chinart123/STM32_Quadcopter/docs/project-architecture.txt

# CẤU TRÚC HỆ THỐNG THƯ MỤC: DUAL-PLATFORM QUADCOPTER

====================================================================
📦 1. STM32_Quadcopter_Legacy_Project (Cấu trúc cũ dự tính - Trước khi Refactor)
====================================================================
 ┣ 📂 1_Docs_and_Reports               <-- (Tài liệu báo cáo đồ án)
 ┃ ┗ 📜 1_M1Report_Template_updated2024.docx
 ┣ 📂 assets                           <-- (Sơ đồ mạch và hình ảnh minh họa lỗi)
 ┃ ┣ 🖼️ Fail-Diagram.png
 ┃ ┣ 🖼️ PASS-DIAGRAM.png
 ┃ ┗ 🖼️ cách-đấu-dây-fail.png
 ┣ 📂 Logs_and_Debug                   <-- (Nhật ký phân tích lỗi động cơ & MOSFET)
 ┃ ┣ 📜 Stage_10-Release-Test_1_motor_Bug_note.md
 ┃ ┣ 📜 Stage10_HW_Measurement_Test_Log.md
 ┃ ┣ 📜 Stage_10.5-Motor_Hardware_Master_Document.md
 ┃ ┗ 📜 Stage-11-Refactor-Circuits.md
 ┣ 📂 Old Core_Files                   <-- (Thư viện I2C cũ xử lý Blocking)
 ┃ ┣ 📜 i2c_mpu_debug.h
 ┃ ┗ 📜 i2c_mpu_debug.c                <-- (Chặn CPU bằng timeout t--)
 ┣ 📂 docs                             <-- (Tài liệu kỹ thuật STM32)
 ┣ 📂 include                          <-- (Header files của HAL)
 ┃ ┣ 📜 drn_main_board_choose.h
 ┃ ┣ 📜 drn_time.h
 ┃ ┣ 📜 drn_button.h
 ┃ ┣ 📜 drn_motor_pwm.h
 ┃ ┗ 📜 drn_timer_pwm.h
 ┣ 📂 src                              <-- (Source files của HAL)
 ┃ ┣ 📜 drn_main_board_choose.c
 ┃ ┣ 📜 drn_time.c                     <-- (Đếm SysTick 1ms)
 ┃ ┣ 📜 drn_button.c
 ┃ ┣ 📜 drn_motor_pwm.c
 ┃ ┗ 📜 drn_timer_pwm.c                <-- (Cấu hình TIM3 500Hz/4kHz)
 ┣ 📜 .gitignore
 ┗ 📜 README.md

====================================================================
📦 2. STM32_Quadcopter_BareMetal (Cấu trúc hiện tại - Chuẩn Zero-Config)
====================================================================
 ┣ 📂 1_Docs_and_Reports               <-- (Tài liệu báo cáo đồ án)
 ┃ ┗ 📜 1_M1Report_Template_updated2024.docx
 ┣ 📂 assets                           <-- (Sơ đồ mạch và hình ảnh minh họa lỗi)
 ┃ ┣ 🖼️ Fail-Diagram.png
 ┃ ┣ 🖼️ PASS-DIAGRAM.png
 ┃ ┗ 🖼️ cách-đấu-dây-fail.png
 ┣ 📂 Logs_and_Debug                   <-- (Nhật ký phân tích lỗi động cơ & MOSFET)
 ┃ ┣ 📜 Stage_10-Release-Test_1_motor_Bug_note.md
 ┃ ┣ 📜 Stage10_HW_Measurement_Test_Log.md
 ┃ ┣ 📜 Stage_10.5-Motor_Hardware_Master_Document.md
 ┃ ┗ 📜 Stage-11-Refactor-Circuits.md
 ┣ 📂 docs                             <-- (Tài liệu kỹ thuật STM32)
 ┃
 ┣ 📂 Old_Core_Files                   <-- (Nơi phong ấn các file Legacy/Blocking thế hệ 1)
 ┃ ┣ 📜 button.c / .h                  <-- (Thế hệ 1 - Đã được thay bởi drn_button)
 ┃ ┣ 📜 main_board_choose.c / .h       <-- (Thế hệ 1 - Đã được thay bởi drn_main_board_choose)
 ┃ ┗ 📜 i2c_mpu_debug.c / .h           <-- (I2C Polling cũ, gây nghẽn CPU)
 ┃
 ┣ 📂 include                          <-- (Header files ĐANG ACTIVE)
 ┃ ┣ 📜 hal_timer_pwm.h                <-- (BẮT BUỘC GIỮ LẠI: Định nghĩa TIM3 PWM)
 ┃ ┣ 📜 drn_button.h
 ┃ ┣ 📜 xx_mpu_data_fusion.h           
 ┃ ┗ ... (các file .h khác)
 ┃
 ┣ 📂 src                              <-- (Source files ĐANG ACTIVE)
 ┃ ┣ 📜 hal_timer_pwm.c                <-- (BẮT BUỘC GIỮ LẠI: Được pid_control.c gọi)
 ┃ ┣ 📜 main.c
 ┃ ┣ 📜 pid_control.c
 ┃ ┣ 📜 drn_button.c
 ┃ ┣ 📜 xx_mpu_data_fusion.c           <-- (Tạm thời giữ ở đây để build qua, chờ Giai đoạn 2)
 ┃ ┗ ... (các file .c khác)
 ┃
 ┣ 📜 stm32f10x.h                      <-- (File CMSIS do Keil RTE quản lý, KHÔNG DI CHUYỂN)
 ┣ 📜 .gitignore                       <-- (Chứa cấu hình loại bỏ thư mục rác Objects/ Listings/)
 ┣ 📜 STM32_Quadcopter.uvprojx         <-- (Đã được Script tự động update đường dẫn)
 ┗ 📜 README.md

📦 ESP32_S3_Quadcopter_RTOS_Project
 ┣ 📂 1_Docs_and_Reports               <-- (Tài liệu báo cáo đồ án)
 ┃ ┗ 📜 1_M1Report_Template_updated2024.docx
 ┣ 📂 assets                           <-- (Công cụ tính toán & Sơ đồ kiến trúc mới)
 ┃ ┣ 🌐 drone_budget.html
 ┃ ┣ 🌐 drone_budget-v2.html
 ┃ ┗ 🖼️ ESP32-S3-DualCore-Architecture.png
 ┣ 📂 Logs_and_Debug                   <-- (Nhật ký phát triển RTOS)
 ┃ ┣ 📜 Design_Analysis_Log.md
 ┃ ┗ 📜 PWM_16kHz_Thermal_Report.md
 ┣ 📂 Old Core_Files                   <-- (Lưu trữ code cũ để tham khảo refactor)
 ┃ ┗ 📜 old_esp32_mpu_i2c_v1.c
 ┣ 📂 docs                             <-- (Tài liệu lý thuyết RTOS)
 ┃ ┣ 📜 Lý thuyết Ngắt (Interrupt) trên ESP32-S3 & FreeRTOS.md
 ┃ ┣ 📜 Thông số Lấy mẫu & Cấu hình MPU6500.md
 ┃ ┗ 📜 Tổng hợp_Kiến_trúc_Lõi_Kép.md
 ┣ 📂 include                          <-- (Header files dùng cho ESP-IDF)
 ┃ ┣ 📜 drn_main_board_choose.h
 ┃ ┣ 📜 drn_time.h
 ┃ ┣ 📜 drn_button.h
 ┃ ┣ 📜 drn_raw_mpu6050.h
 ┃ ┣ 📜 drn_mpu6050.h
 ┃ ┣ 📜 drn_motor_pwm.h
 ┃ ┗ 📜 drn_timer_pwm.h
 ┣ 📂 src                              <-- (Source files & ESP-IDF Components)
 ┃ ┣ 📜 drn_main_board_choose.cpp
 ┃ ┣ 📜 drn_time.cpp                     <-- (FreeRTOS Tick/esp_timer)
 ┃ ┣ 📜 drn_button.cpp
 ┃ ┣ 📜 drn_raw_mpu6050.cpp
 ┃ ┣ 📜 drn_mpu6050.cpp
 ┃ ┣ 📜 drn_motor_pwm.cpp
 ┃ ┗ 📜 drn_timer_pwm.cpp                <-- (Cấu hình LEDC 16kHz)
 ┣ 📜 CMakeLists.txt                   <-- (Project-level: Khởi tạo dự án ESP-IDF)
 ┣ 📜 sdkconfig                        <-- (Cấu hình CONFIG_ cho RTOS, Clock 240MHz...)
 ┣ 📂 main                             <-- (Thư mục ứng dụng chính)
   ┣ 📜 CMakeLists.txt                 <-- (Component-level: Đăng ký source code)
   ┗ 📜 main.cpp                       <-- (Entry point: Khởi tạo Task điều khiển bay)
 ┣ 📂 Arduino_IDE/
 ┃ ┗ 📂 ESP32_Quadcopter/                   # Tên thư mục = tên file .ino
 ┃    ┣ 📜 ESP32_Quadcopter.ino             # Entry point (setup/loop)
 ┃    ┣ 📂 src/                             # Symbolic link hoặc copy tới ../src/
 ┃    ┃  ┣ 🔗 drn_main_board_choose.cpp -> ../../../src/drn_main_board_choose.cpp
 ┃    ┃  ┣ 🔗 drn_time.cpp                 -> ../../../src/drn_time.cpp
 ┃    ┃  ┣ 🔗 drn_button.cpp               -> ../../../src/drn_button.cpp
 ┃    ┃  ┣ 🔗 drn_raw_mpu6050.cpp               -> ../../../src/drn_raw_mpu6050.cpp
 ┃    ┃  ┣ 🔗 drn_mpu6050.cpp               -> ../../../src/drn_mpu6050.cpp
 ┃    ┃  ┣ 🔗 drn_timer_pwm.cpp            -> ../../../src/drn_timer_pwm.cpp
 ┃    ┃  ┗ 🔗 drn_motor_pwm.cpp            -> ../../../src/drn_motor_pwm.cpp
 ┃    ┣ 📂 include/                         # Symbolic link tới ../include/
 ┃    ┃  ┣ 🔗 drn_main_board_choose.h      -> ../../../include/drn_main_board_choose.h
 ┃    ┃  ┣ 🔗 drn_time.h                   -> ../../../include/drn_time.h
 ┃    ┃  ┣ 🔗 drn_button.h                 -> ../../../include/drn_button.h
 ┃    ┃  ┣ 🔗 drn_raw_mpu6050.h                 -> ../../../include/drn_raw_mpu6050.h
 ┃    ┃  ┣ 🔗 drn_mpu6050.h                 -> ../../../include/drn_mpu6050.h
 ┃    ┃  ┣ 🔗 drn_timer_pwm.h              -> ../../../include/drn_timer_pwm.h
 ┃    ┃  ┗ 🔗 drn_motor_pwm.h              -> ../../../include/drn_motor_pwm.h
 ┃    ┗ 📂 libraries/                       # (Tuỳ chọn) Thư viện bổ sung cho Arduino
 ┣ .gitignore
 ┗ README.md
