chinart123/STM32_Quadcopter/assets/nmos.pdf

EE 230 | MOSFETs – 1

## Metal oxide semiconductor field effect transistors (MOSFETs)

A newer form of transistor which has pretty much replaced BJT technology for all digital applications and much of analog.

Basically, an FET is a resistor whose resistance can be controlled through a third terminal. So the transistor mechanism is much different than that of the BJT. A BJT used both electrons and holes injected across the junctions (hence bipolar). An FET uses either electrons or holes (hence unipolar) flowing by drift current between two contacts (source and drain). The amount of flow is controlled by a voltage applied at the gate.

electron-current device: n-channel MOSFET (NMOS) hole-current device: p-channel MOSFET (PMOS)

Using NMOS and PMOS together (known as CMOS) offers some significant advantages in circuit design.

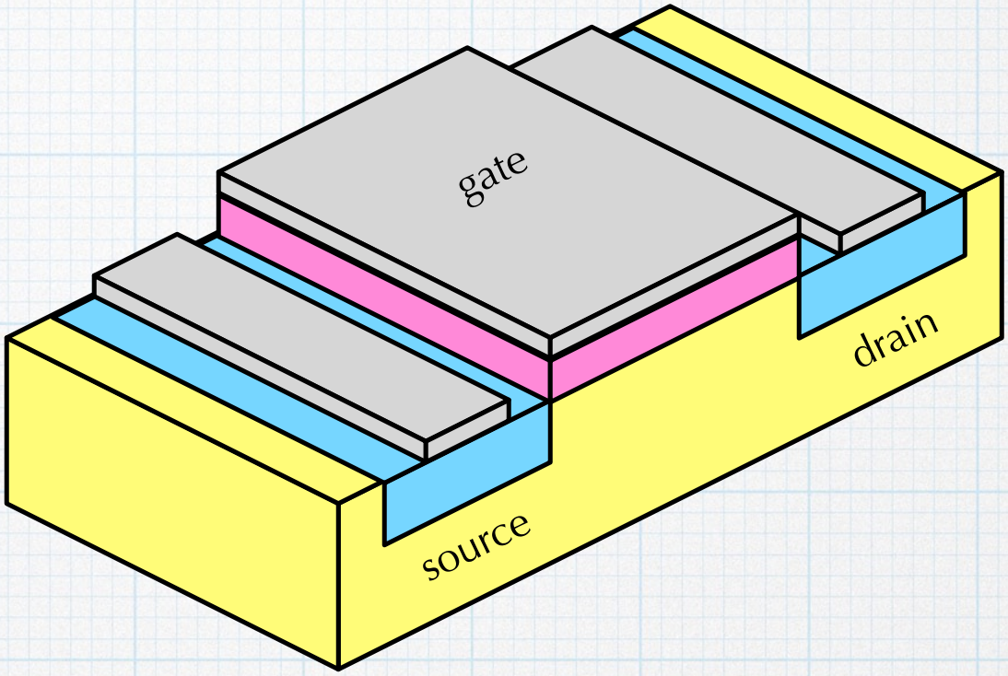
[picture p4: figure]
source; drain; oxide; gate

PMOS has n- and p-type regions reversed. (Duh!)

Start with a p-type substrate.

Form two n-type regions
(source & drain)

Form a thin layer of silicon dioxide on the p-type silicon between source and drain

Put metal contacts on the
source, drain, and oxide (gate) for electrical connection

## Basic NMOS structure

(n-channel device)

## Basic NMOS structure

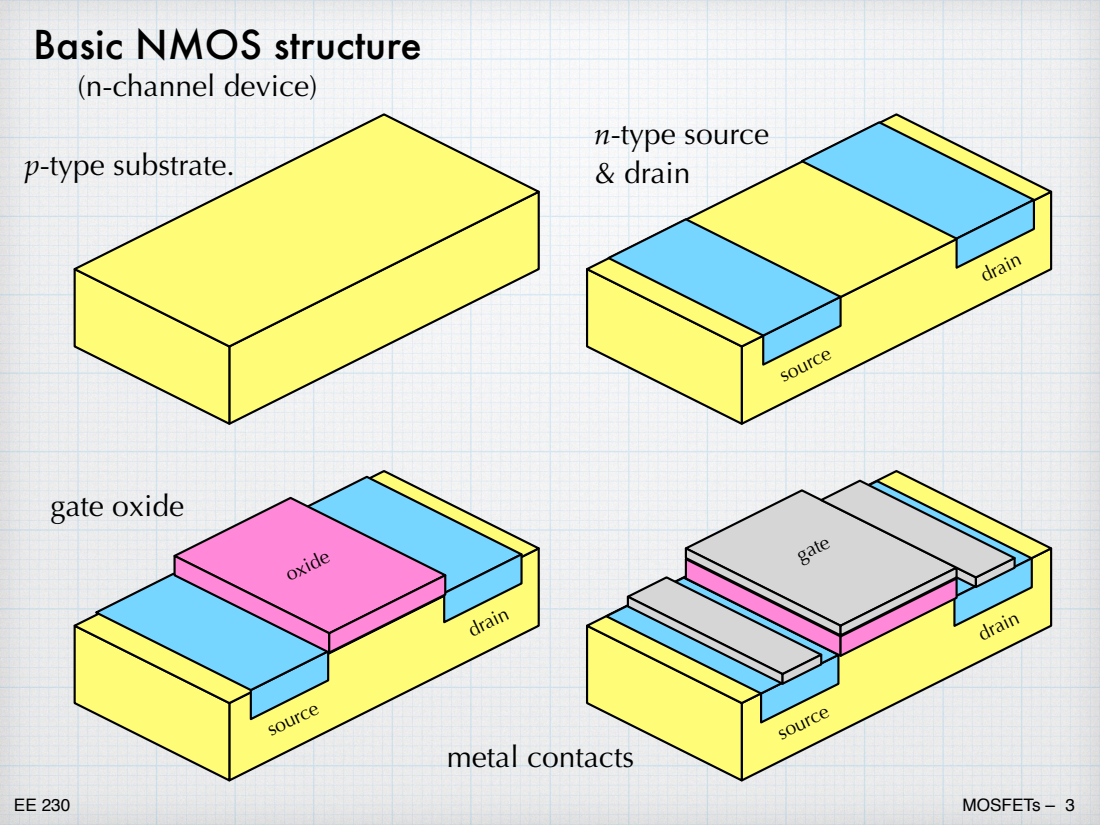
[picture p5: page 3]
source; drain; oxide; gate; (n-channel device); p-type substrate.; n-type source & drain; gate oxide; metal contacts

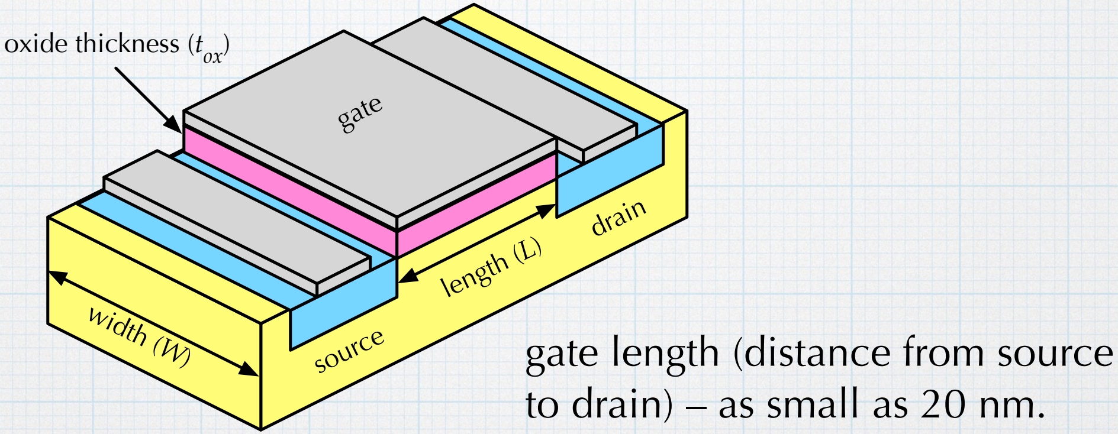
[picture p6: figure]
source; drain; oxide; gate; gate length (distance from source to drain) – as small as 20 nm.; length (L); width (W); oxide thickness (t

EE 230 | MOSFETs –

4

## Critical dimensions

width: typical L to 10 L
(W/L ratio is important)

oxide thickness: typical 1 - 10 nm.

Will current flow?
Apply a voltage between drain and source (VDS).

If VDS > 0, the diode at the drain end will be reverse-biased, preventing current flow.

Reversing the polarity doesn’t help, because then the other junction will be reverse biased.

source | drain

gate

p

n | n

–

+

VDS

## The MOS capacitor

The secret to MOSFET operation lies in the MOS capacitor (the central part of the FET).

The structure is essentially a little parallel-plate capacitor formed by the gate metal and the semiconductor with the oxide as the dielectric.

Define oxide
capacitance

&JDWH =

R[$

WR[

&R[ =

R[

WR[

gate body

substrate (body)

units: F/m² (or F/µm²)

εox = 3.9εo = 3.9(8.85x10⁻¹² F/m) for tox = 10 nm (10⁻⁸ m)
Cox = 0.00345 F/m²
= 3.45x10⁻¹⁵ F/µm²

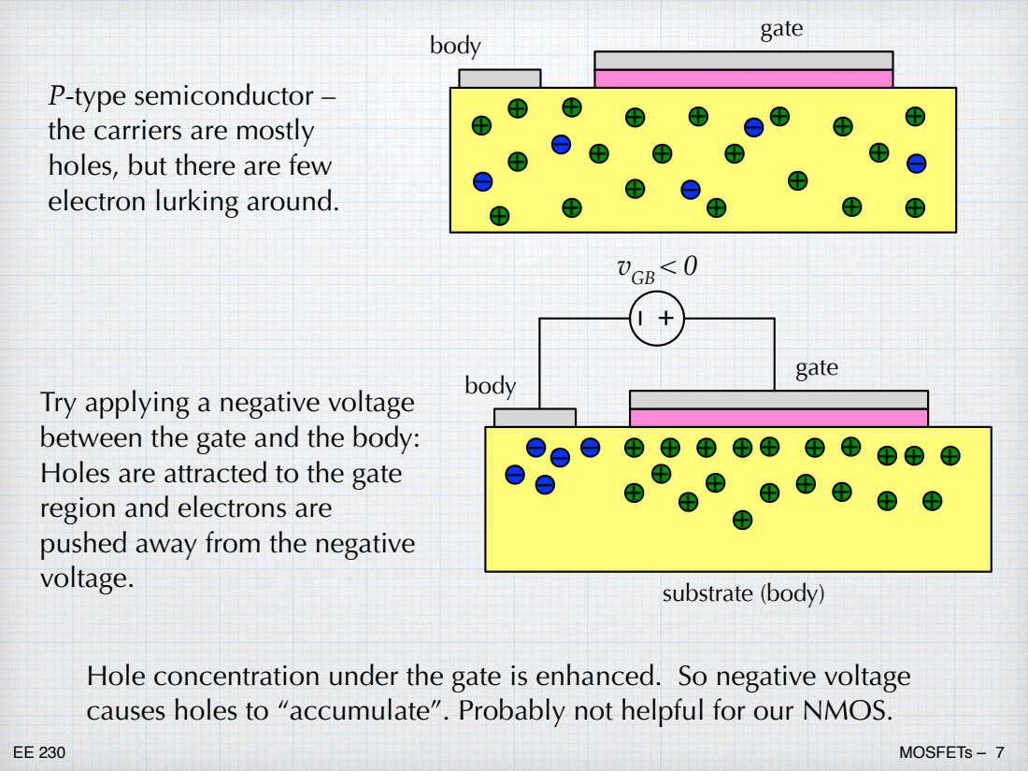
[picture p7: page 7]
gate body; gate; vGB < 0; body; substrate (body)

P-type semiconductor –
the carriers are mostly
holes, but there are few
electron lurking around.

Try applying a negative voltage
between the gate and the body:
Holes are attracted to the gate
region and electrons are
pushed away from the negative
voltage.

Hole concentration under the gate is enhanced. So negative voltage
causes holes to “accumulate”. Probably not helpful for our NMOS.

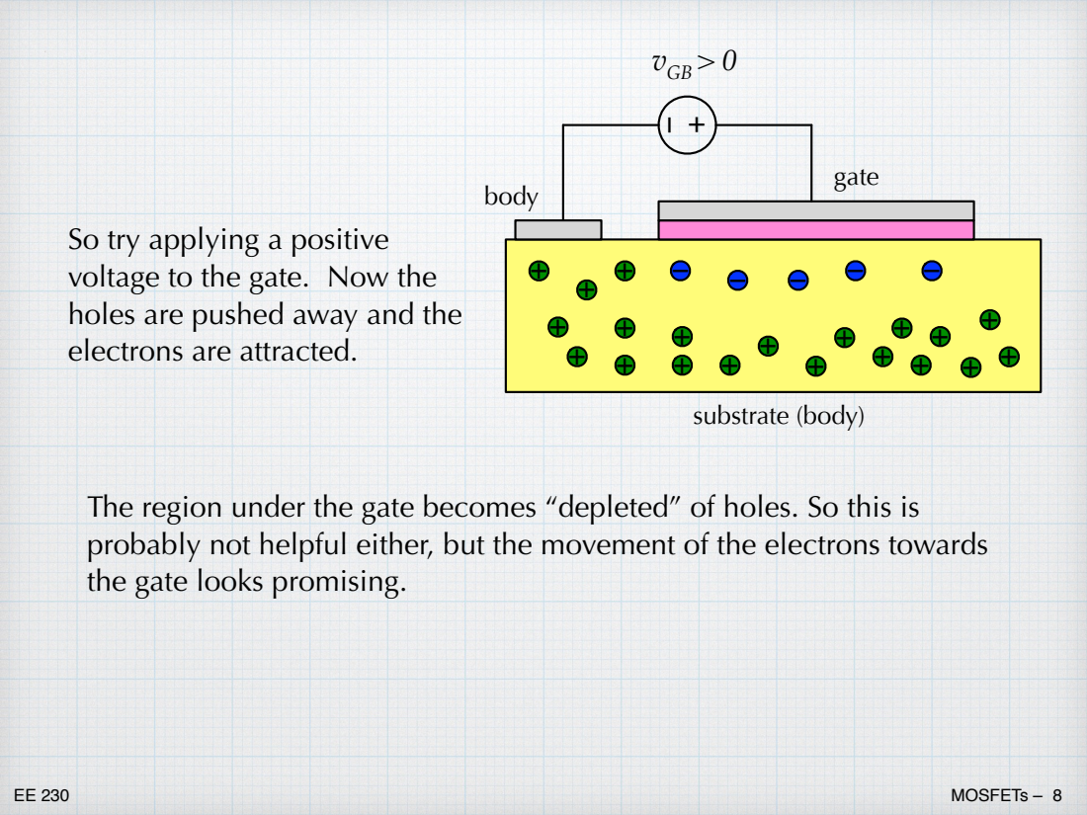
[picture p8: page 8]
gate; vGB > 0; body; substrate (body)

So try applying a positive
voltage to the gate. Now the
holes are pushed away and the
electrons are attracted.

The region under the gate becomes “depleted” of holes. So this is
probably not helpful either, but the movement of the electrons towards
the gate looks promising.

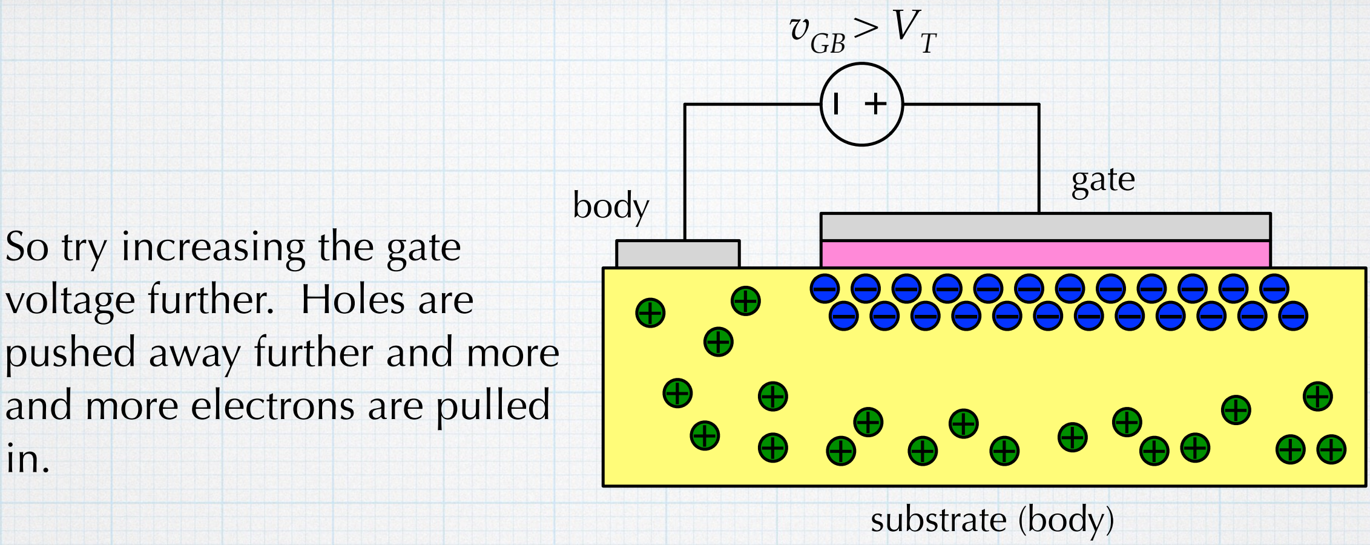
[picture p9: figure]
So try increasing the gate voltage further. Holes are pushed away further and more and more electrons are pulled in.; gate; vGB > VT; body; substrate (body)

At a sufficiently high voltage, enough electrons will gather together to make the region under the gate “invert” and behave like it was n-type!

The gate voltage required create the electron “inversion layer” is called the threshold voltage, VT

. If the voltage is increase beyond VT

, even
more electrons are gathered together under the gate.

+ – – – – – – – – – – – – – – – – – – – – – – – –

## The inversion layer

How many electrons are in the inversion layer? The definition of the threshold voltage says that when vGB = VT, the electron concentration in the inversion layer is equal to the
hole concentration in the substrate:
n(inversion) = p(substrate).

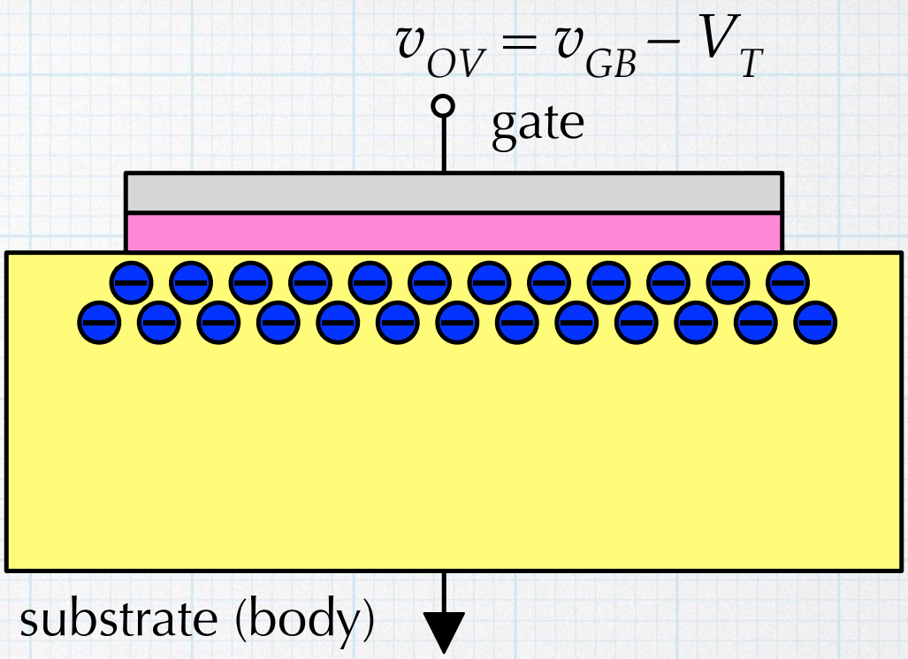
[picture p10: figure]
gate; substrate (body); vOV = vGB – VT

This gives just enough electrons so that the region under the gate begins to act like it is n-type. A detailed physical description is beyond our capabilities now. (See EE 332 and beyond.) But we can get a good approximation by using the fact that the MOS structure is basically a capacitor. Once the gate voltage is bigger than the threshold, electrons pile up under gate just like charge on a plate of a capacitor.

4LQY
$

= &R[ (Y%* 97)= TQV

where ns is the sheet concentration of electrons in the inversion layer. (electrons per unit area).

– – – – – – – – – – – – – – – – – – – – – – – –

Qinv = Cgate (vGB VT)

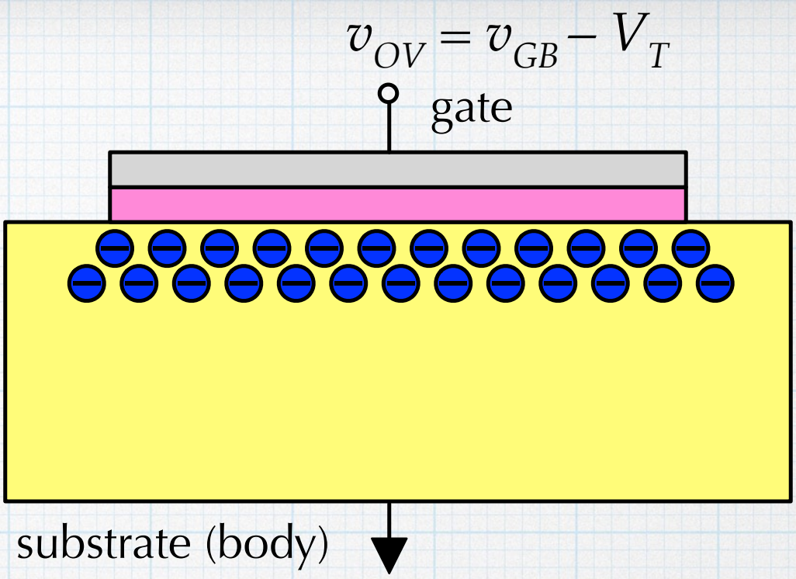
[picture p11: figure]
substrate (body); vOV = vGB – VT

The threshold voltage | gate
| – – – – – – – – – – – – – – – – – – – – – – – –

The threshold voltage for a MOSFET depends primarily on two things. The doping level of the substrate and the
thickness of the insulating gate oxide
layer.

The definition of threshold is that the electron concentration under the gate is equal to the hole concentration in the rest of the substrate. If the hole concentration in the substrate is higher (due to higher doping) more voltage is required to induce the higher number of electrons needed for inversion. Increased doping means higher threshold.
The electric field in MOS capacitor in the gate that controls what is happening in the inversion layer. Since E ∝ vGB/tox , making the oxide thicker requires more voltage in order to create the same electric field. So a thicker oxide also leads to higher a threshold voltage.
Integrated circuit fabrication engineers work very hard to control the threshold voltages of the MOSFETs. Not easy when there are millions (or billions) of transistors in a chip!

vGB < 0 | hole accumulation
0 < vGB < VT | carrier depletion
vGB > VT | inversion – electron layer forms, qns = Cox(vGB – VT)

So through the application of the gate voltage, we control carriers under the gate.

## Summary of MOS capacitor operation

Now we see a mechanism by which we might get current to flow between drain and source.
Apply a gate voltage to create an electron inversion layer. Then electrons from the source can flow to the drain using the inversion

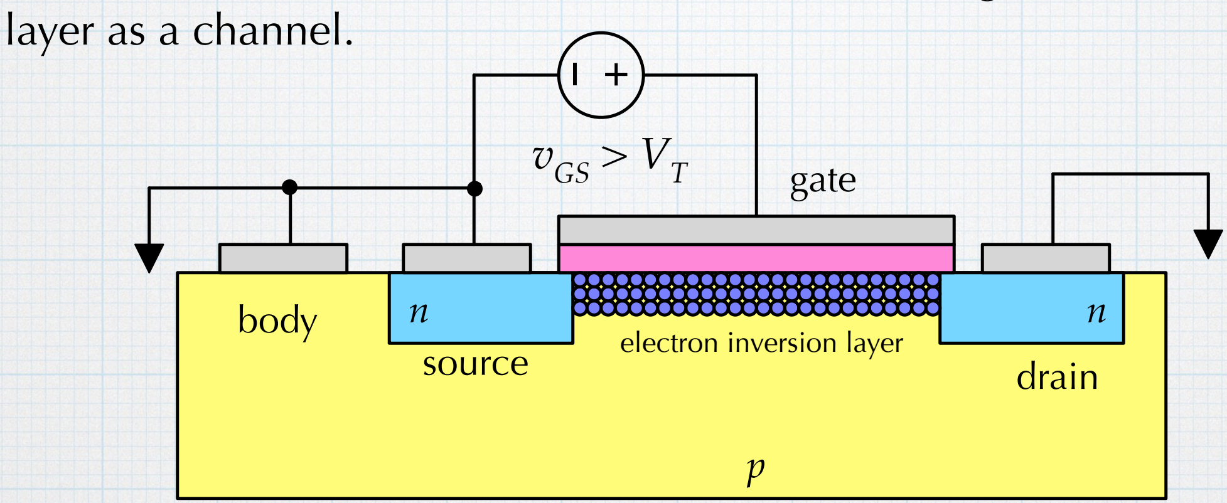
[picture p12: figure]
layer as a channel.; drain source; gate; vGS > VT; electron inversion layer; body

For now, we connect the source to the body (call this ground) and apply the controlling voltage between the gate and the source. This is OK for the time being, but we will have to revisit the issue of the body connection later. With the drain also at ground, the inversion layer (channel) is uniform between source and drain.

## Drain resistance

With the inversion layer in place, we can apply a positive voltage between the drain and source. This creates an electric field along the channel that will push electrons from the source through the inversion layer to the drain. The moving electrons represent a current in the opposite direction — from drain to source.

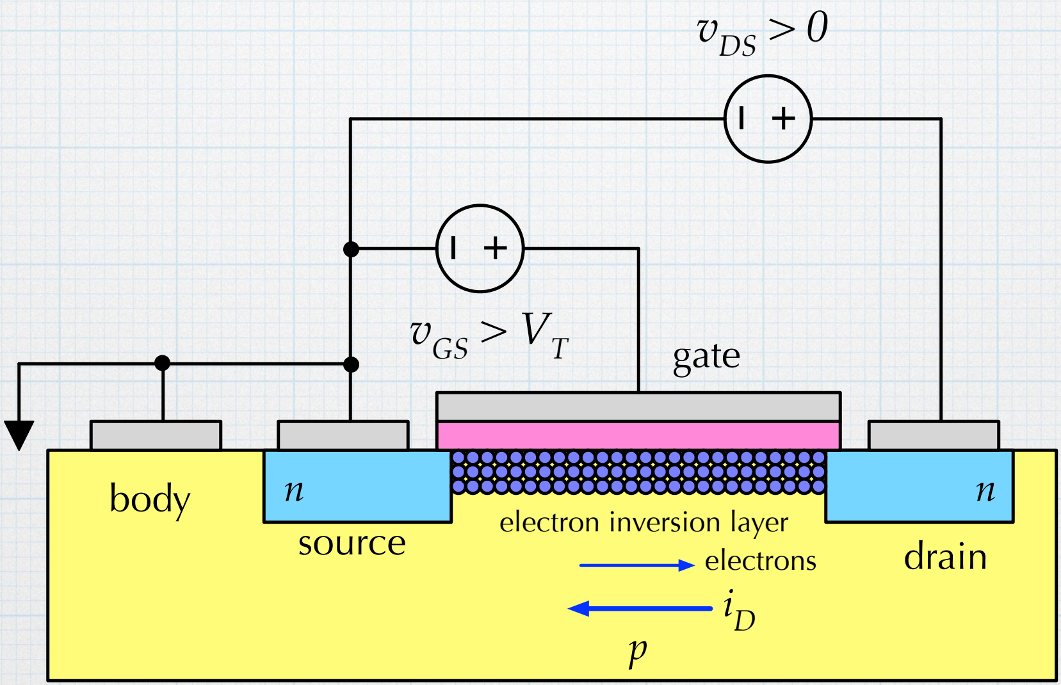
[picture p13: figure]
drain source; gate; vGS > VT; electron inversion layer; vDS > 0; electrons; body

At first inspection, the current is

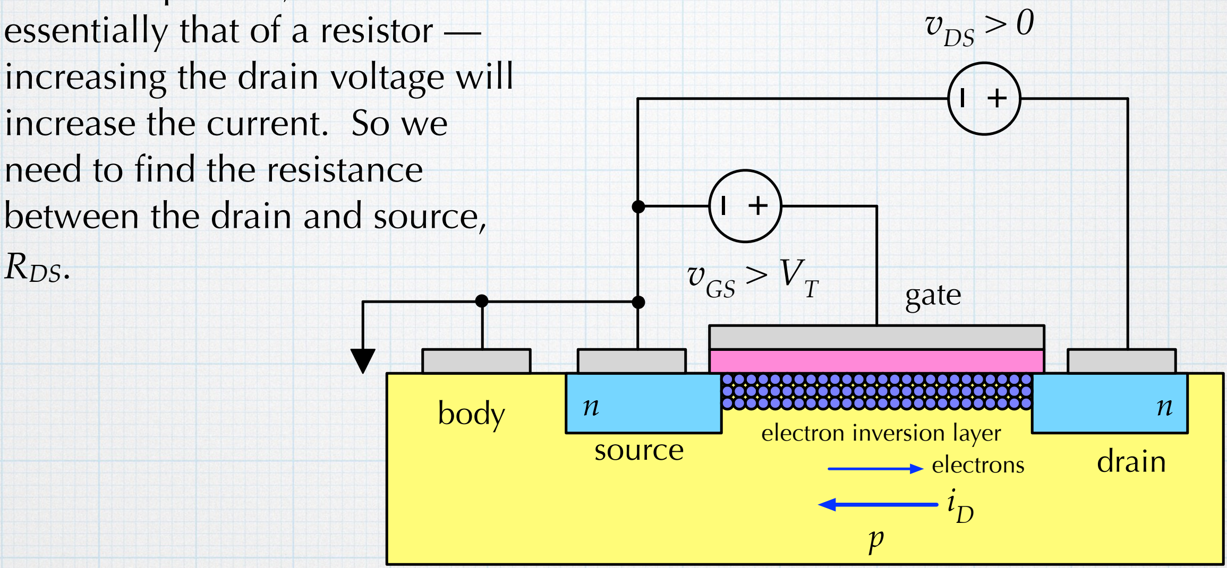
[picture p14: figure]
essentially that of a resistor — increasing the drain voltage will increase the current. So we need to find the resistance between the drain and source,; RDS.; drain source; gate; vGS > VT; electron inversion layer; vDS > 0; electrons; body

The total resistance is the sum the resistances of the three regions: RDS = Rsource + Rinversion + Rdrain. Usually, the source and drain are very heavily doped (lots of electrons) and so the resistances in those regions are very small. Most of the resistance is associated with the inversion layer so

that RDS ≈ Rinversion.

Using the basic definition for a resistor:

where ninv is the electron concentration (m⁻³) in the inversion layer, tinv is the “thickness” of the inversion layer, µn is the electron mobility, q is the charge on one electron and L and W are the gate length and width.

The electron concentration and inversion layer thickness are difficult to quantify because of the sheet-like nature of the inversion layer. However, the product ninv· tinv can be re-expressed more easily – it represents the “sheet concentration” (m⁻²) of electrons in the inversion layer, which we denote as ns.

We saw earlier that: TQV = &R[ (Y*6 97)

L' =

Y'6

5'6

=

TܟQQLQYWLQY :

/

Y'6

ρinv =

1

qμnninv

RDS = ρ

L
A

=

ρ

tinv L

W

Using the basic definition for a resistor:

ρinv =

1

qμnninv
where ninv is the electron concentration (m⁻³) in the inversion layer, tinv is the “thickness” of the inversion layer, µn is the electron mobility, q is the charge on one electron and L and W are the gate length and width. (See slide 4 for a reminder of the 3D geometry.) Putting the equations together:

RDS = ρinv

L
A

=

ρinv

tinv L

W

RDS =

1

qμnninvtinv L

W

L' =

Y'6

5'6

=

TܟQQLQYWLQY :

/

Y'6

The electron concentration and inversion layer thickness are difficult to quantify because of the sheet-like nature of the inversion layer. However, the product ninv· tinv can be re-expressed more easily – it represents the “sheet concentration” (m⁻²) of electrons in the inversion layer, which we denoted earlier as ns.

We saw earlier that: TQV = &R[ (Y*6 97)

iD =

qμnns

W

L

# vDS

L' =

ܟQ&R[
:
/

(Y*6 97)

Y'6 RDS =

1
μnCox

W
L
(vGS VT)

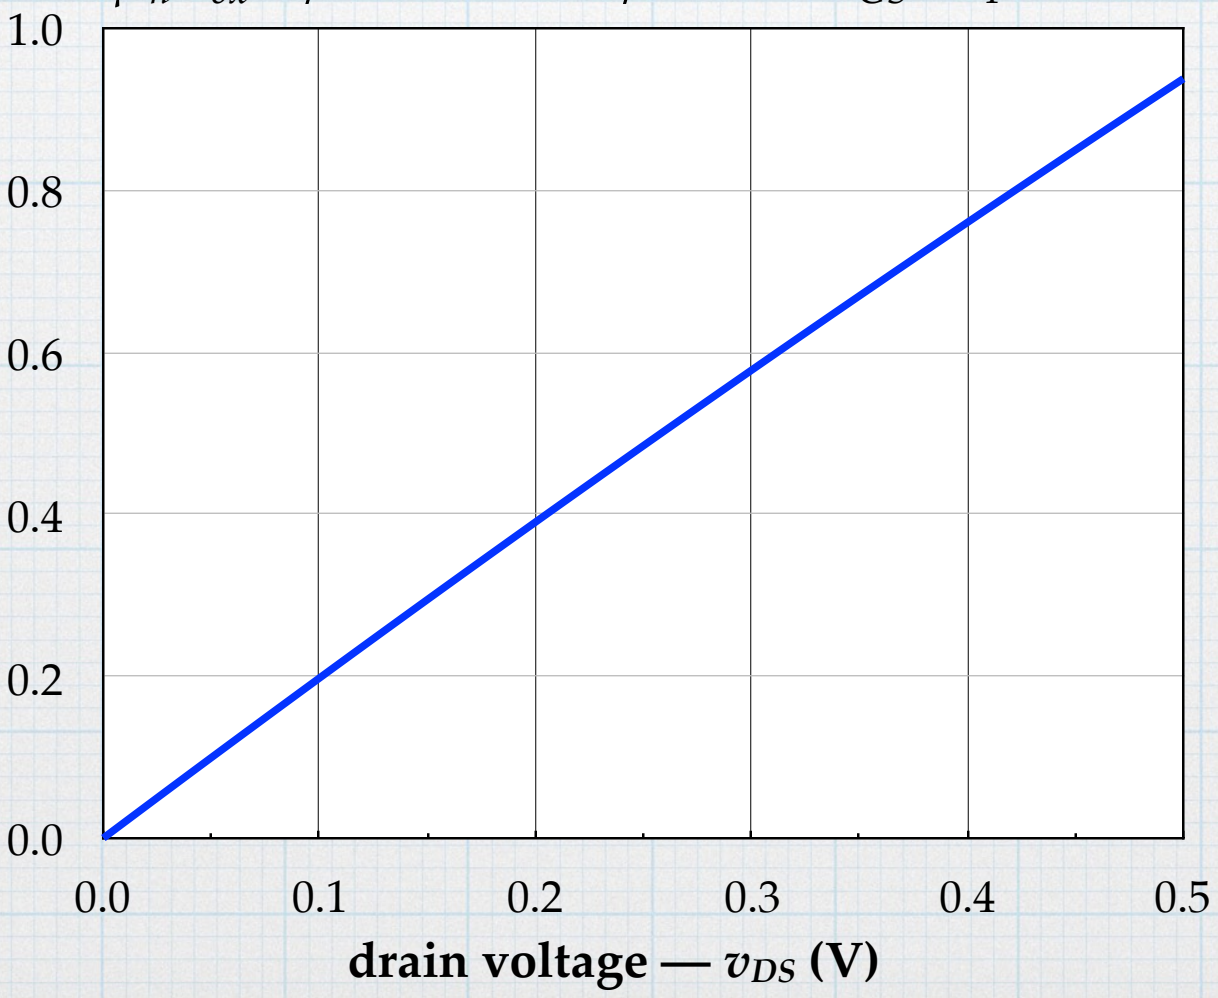
[picture p15: figure]
drain voltage — vDS (V)

µnCoxW/L = 0.5 mA/V² and vGS–VT = 4 V.

drain current —

iDS (mA)

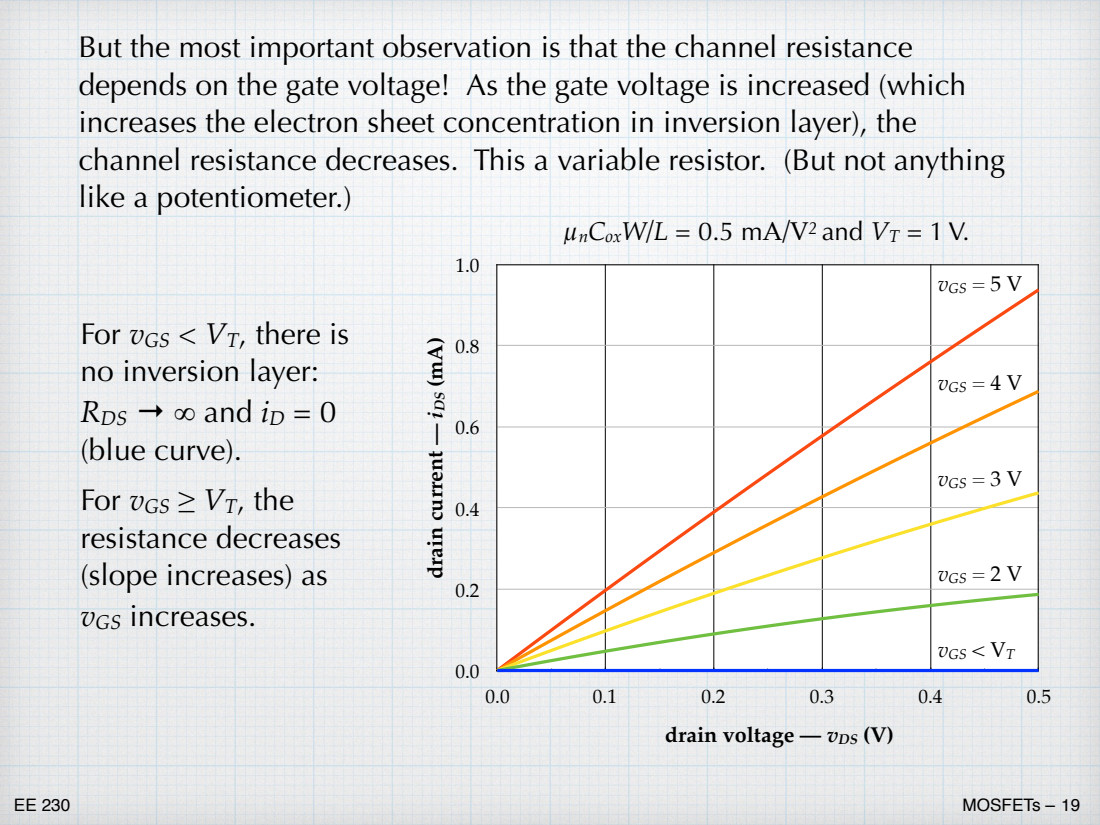
[picture p16: page 19]
drain current —; iDS (mA)

But the most important observation is that the channel resistance
depends on the gate voltage! As the gate voltage is increased (which
increases the electron sheet concentration in inversion layer), the
channel resistance decreases. This a variable resistor. (But not anything
like a potentiometer.)

µnCoxW/L = 0.5 mA/V² and VT = 1 V.

vGS = 5 V

For vGS < VT, there is
no inversion layer:
RDS → ∞ and iD = 0
(blue curve).
For vGS ≥ VT, the
resistance decreases
(slope increases) as
vGS increases.

vGS = 4 V

vGS = 3 V

vGS = 2 V

vGS < VT

drain voltage — vDS (V)

However, the picture gets more complicated as vDS increases.

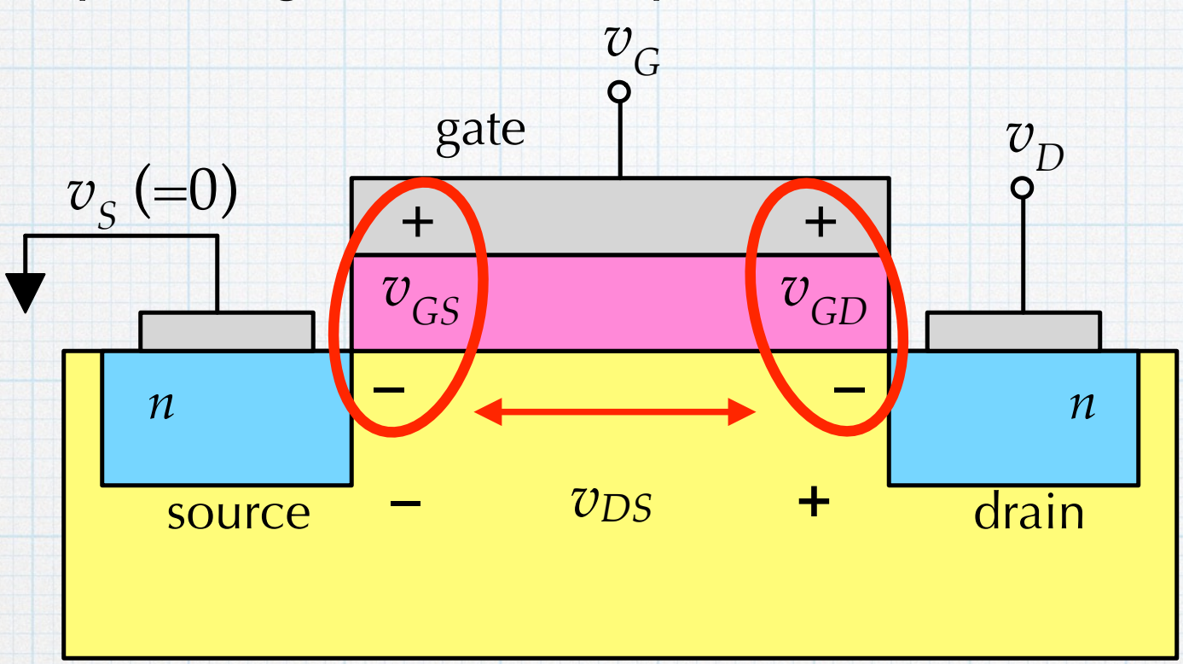
[picture p17: figure]
source; drain; gate; vGS; vGD; vDS

The electron sheet concentration depends on the local voltage of the semiconductor underneath the gate. In the MOS capacitor, the voltage of the semiconductor was the same everywhere, so the electron concentration was uniform. In the case of the MOSFET, the local voltage under the gate can vary from one end to the other. At the source end, the channel voltage is 0, (because we have tied the source to ground). At the drain end, the channel voltage is vD, because we have applied a voltage there in order to make current flow. In between, the channel voltage ranges between 0 and vD.

## Drain resistance

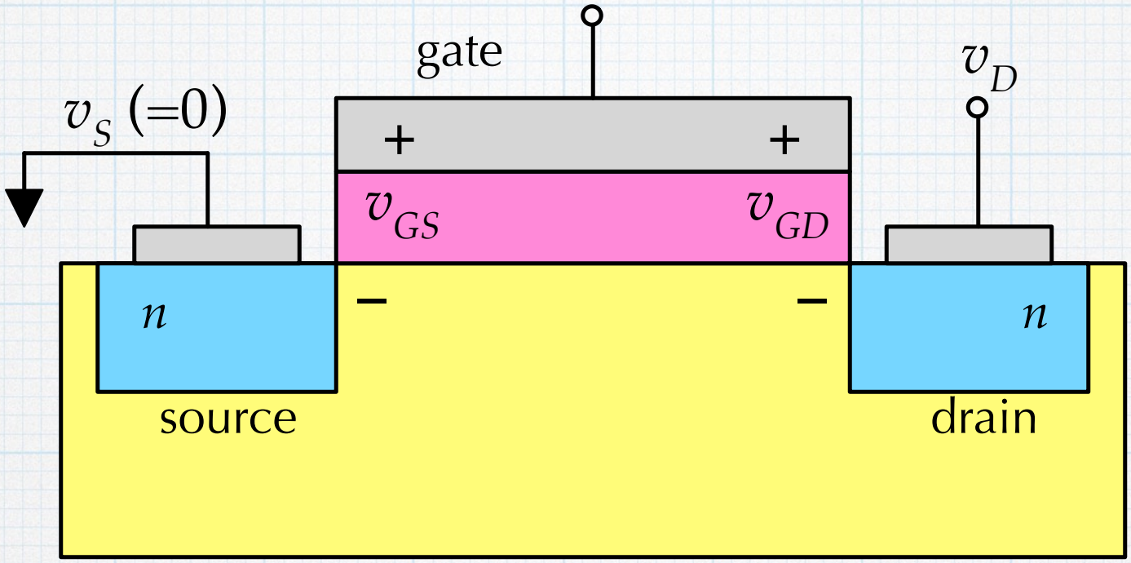
[picture p18: figure]
source; drain; gate; vGS; vGD

Since vGD = vGS – vDS, then qns = Cox(vGS – vDS – VT) at the drain end. Increasing vDS decreases vGD and so decreases the electron concentration at the drain end, increasing the incremental resistance at the drain end.

The electron sheet concentration is determined by the difference between the gate voltage and the local channel voltage. At the source end, qns = Cox(vGS – VT). At the drain end, qns = Cox(vGD – VT).

vG

The result of all this is that the inversion layer (channel) resistance is actually non-linear – the resistance changes as the drain voltage changes.

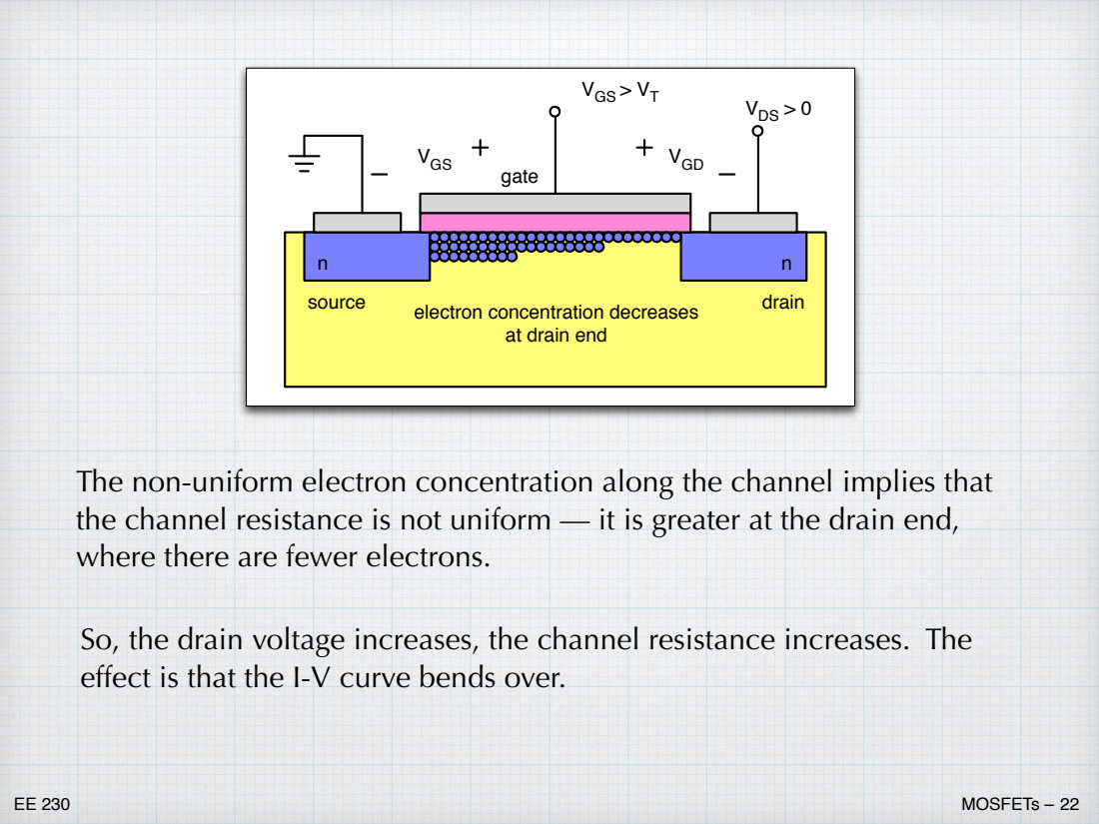
[picture p19: page 22]
source; drain; gate; VDS > 0; VGS > VT; VGS; VGD

electron concentration decreases

at drain end

The non-uniform electron concentration along the channel implies that
the channel resistance is not uniform — it is greater at the drain end,
where there are fewer electrons.

So, the drain voltage increases, the channel resistance increases. The
effect is that the I-V curve bends over.

So a more correct analysis of the current flow shows that the iD-vDS relationship is not linear, but parabolic. (See EE 332.)

Exercise: Show that this reduces to the linear equation for small values of

vDS.

L' =

ܟQ&R[

:
/
(Y*6 97) Y'6 Y

'6

µnCoxW/L = 0.5 mA/V² and vGS–VT = 4 V.

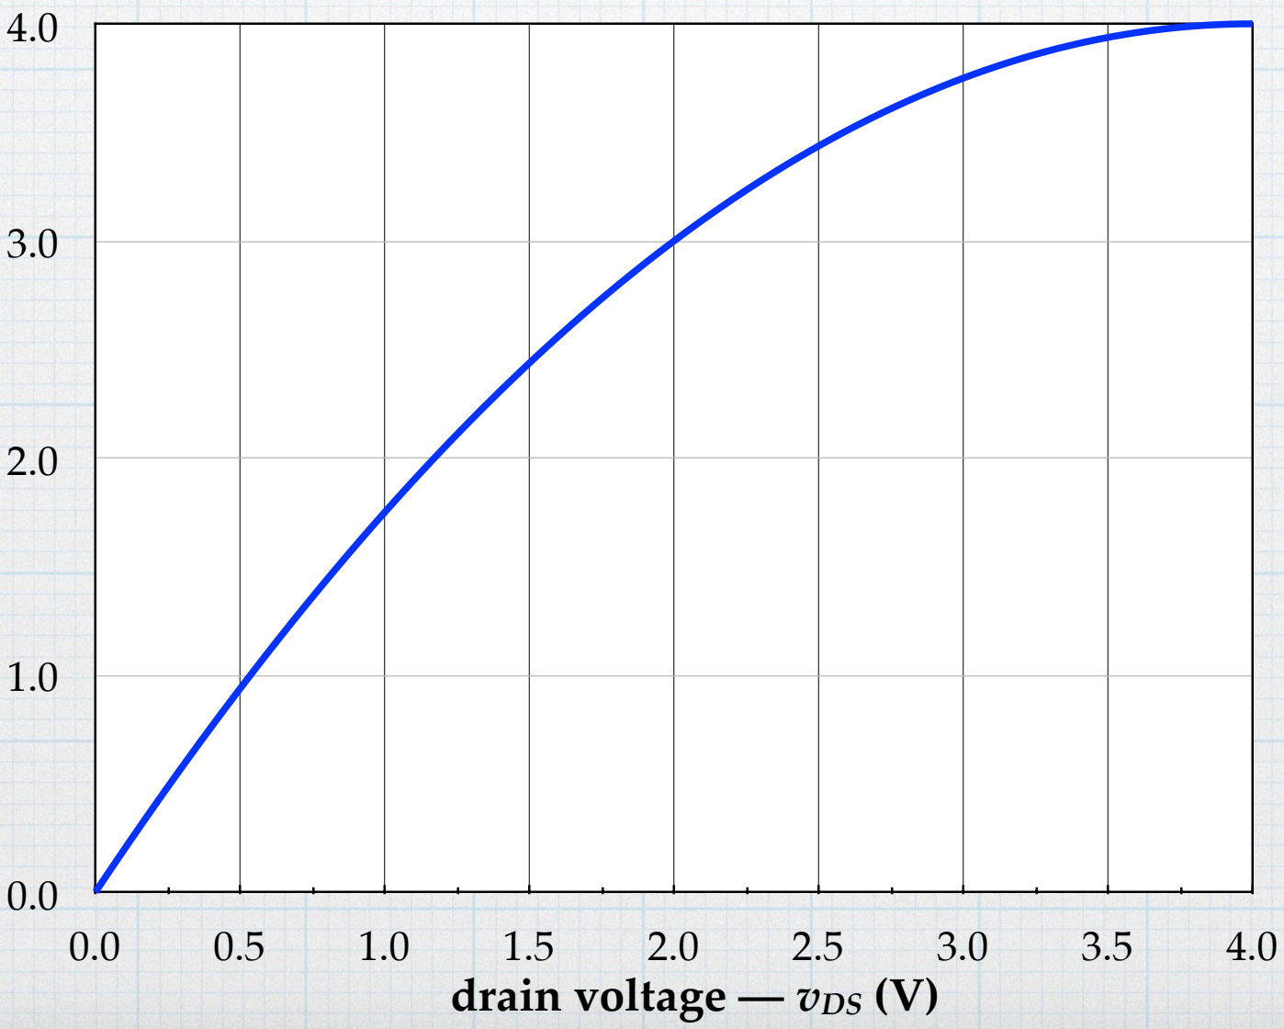
[picture p20: figure]
drain voltage — vDS (V)

drain current —

iDS (mA)

This mode of operation is known as "linear" or "ohmic". (Some old codgers also call is "triode" — but don't use that.)

L' =

ܟQ&R[

:
/
(Y*6 97) Y'6 Y

'6

. =

ܟQ&R[

:
/

Notation: To save on ink and time, define the constant in front as:

The units of this “MOS current parameter” are A/V². Or more typically mA/V². (Check it.)

Note: This use of K is not standard. Different textbooks will handle the current parameter differently.

Now take the final step: If vDS is increased sufficiently, we reach a point where vGD < VT. The electron
concentration should
disappear at the drain end!

## current saturation

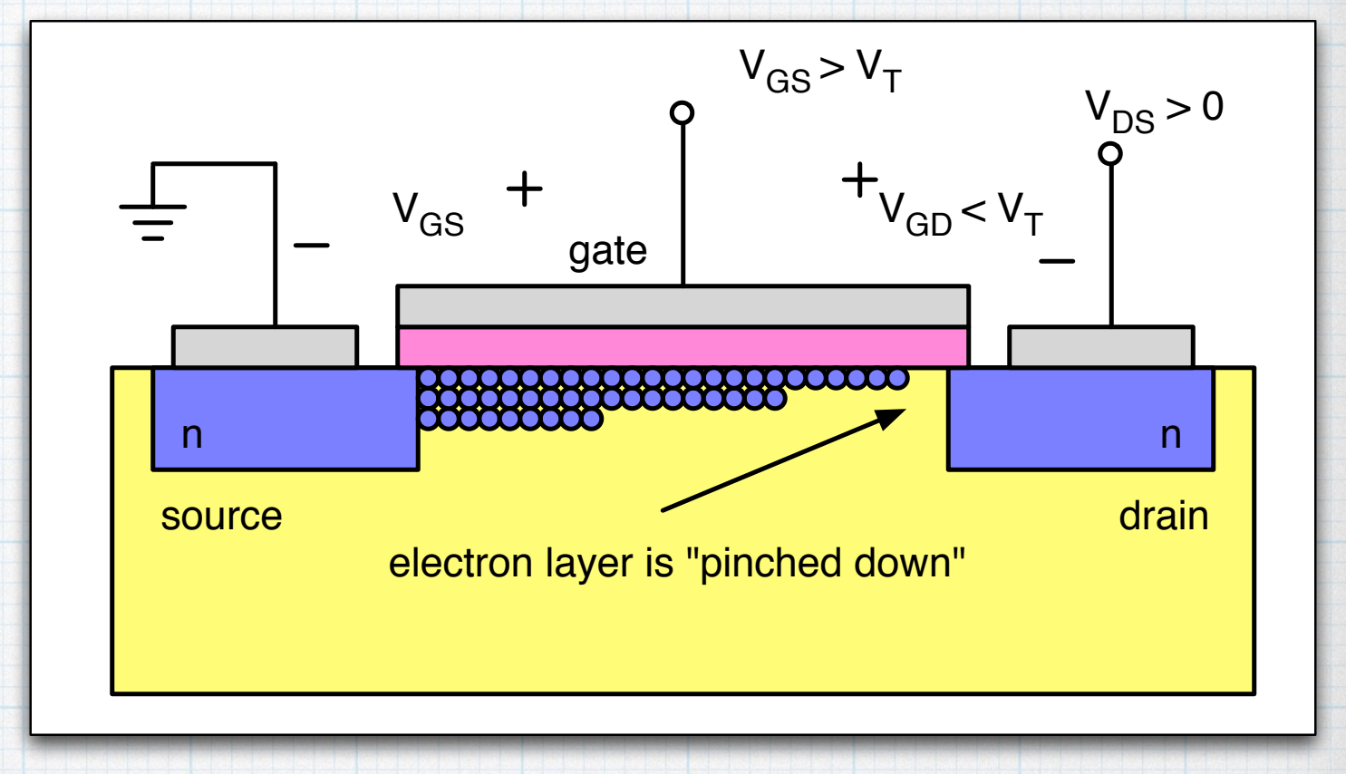
[picture p21: figure]
source; drain; gate; VDS > 0; VGS > VT; electron layer is "pinched down"; VGS; VGD < VT

The usual terminology is to say that the channel is “pinched off” at the drain end, but this is slightly misleading. If the channel were truly pinched off, then the electron concentration would go to zero there and the current would necessarily have to go to zero, also.
Instead, it might be better to say that the channel is “pinched down”. The electron concentration goes to some minimum value, but never really shuts off. In effect, the flowing current works to hold the channel open, even though the drain voltage seems high enough to truly pinch off the channel.

The mathematical analysis of what happens in a FET at pinch-off is a fairly complicated problem in electromagnetics – definitely beyond our current capabilities. (Again, see EE 332.)
However, the end result on the device behavior is easy to grasp – the current saturates at the pinch down value. For higher values of vDS, the current stays constant at a constant value.

The condition for the NMOS going reaching the “pinch-down” condition is vGD ≤ VT. This can be re-expressed in terms of vDS and vGS.

To determine the saturation current, we can insert the pinch-down condition given above into the iD-vDS equation from the ohmic region of operation. Then the saturated current is

Y'6 Y*6 97

L' (VDW)=

ܟQ&R[

:
/

[Y*6 97]

= . [Y*6 97]

(Work out these details for yourself.)

Fix vGS and vary vDS.
Plot the drain current.

## NMOS iD-vDS curves

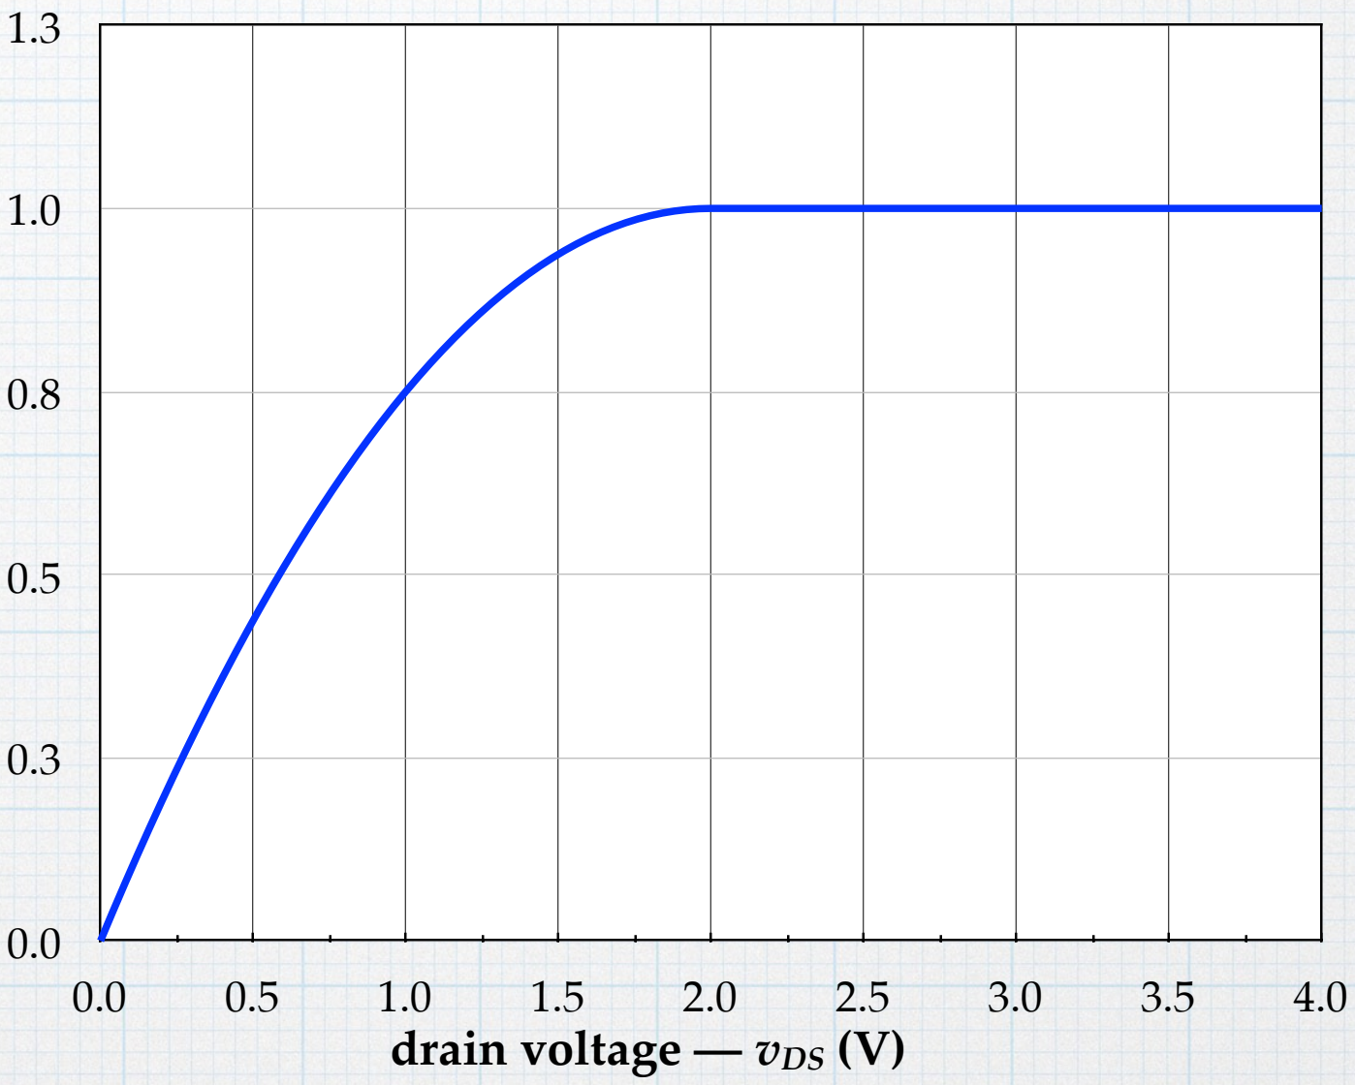
[picture p22: figure]
drain voltage — vDS (V)

For small vDS (vDS < vGS - VT), the NMOS will be in the ohmic region. At higher vDS (vDS ≥ vGS - VT), the channel pinches down and the current saturates.
If vGS < VT, there is no inversion layer and the NMOS is off (iD = 0).

drain current —

iDS (mA)

## NMOS iD-vDS curves

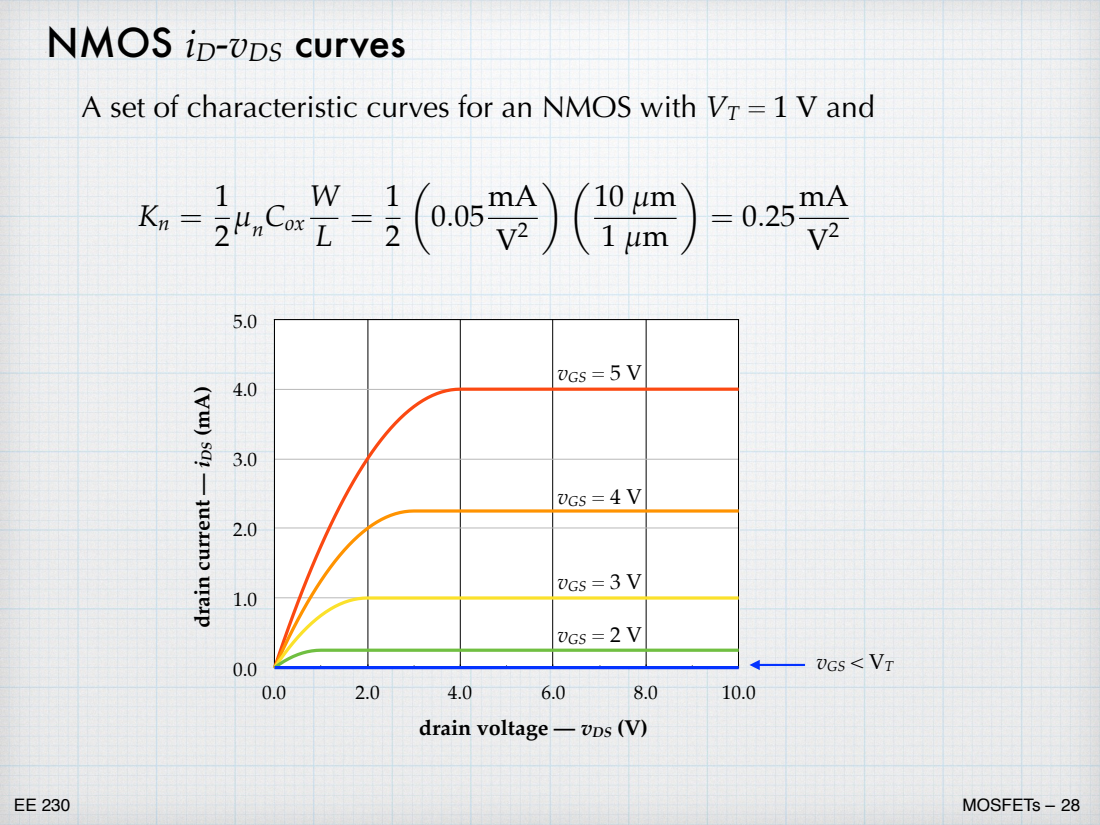
[picture p23: page 28]
MOSFETs –; μnCox; vGS = 5 V; drain current —; iDS (mA); vGS < VT

A set of characteristic curves for an NMOS with VT = 1 V and

vGS = 4 V

vGS = 3 V

vGS = 2 V

drain voltage — vDS (V)

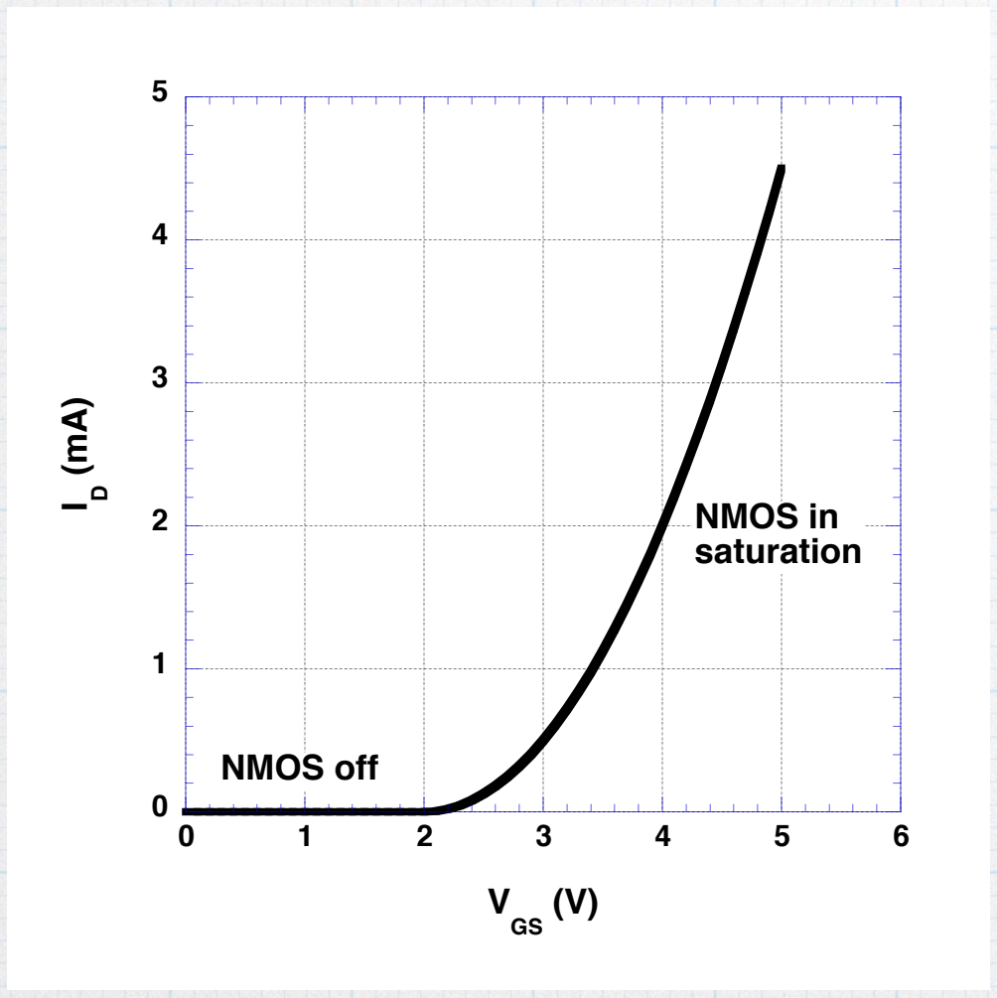
[picture p24: figure]
NMOS off; NMOS in saturation
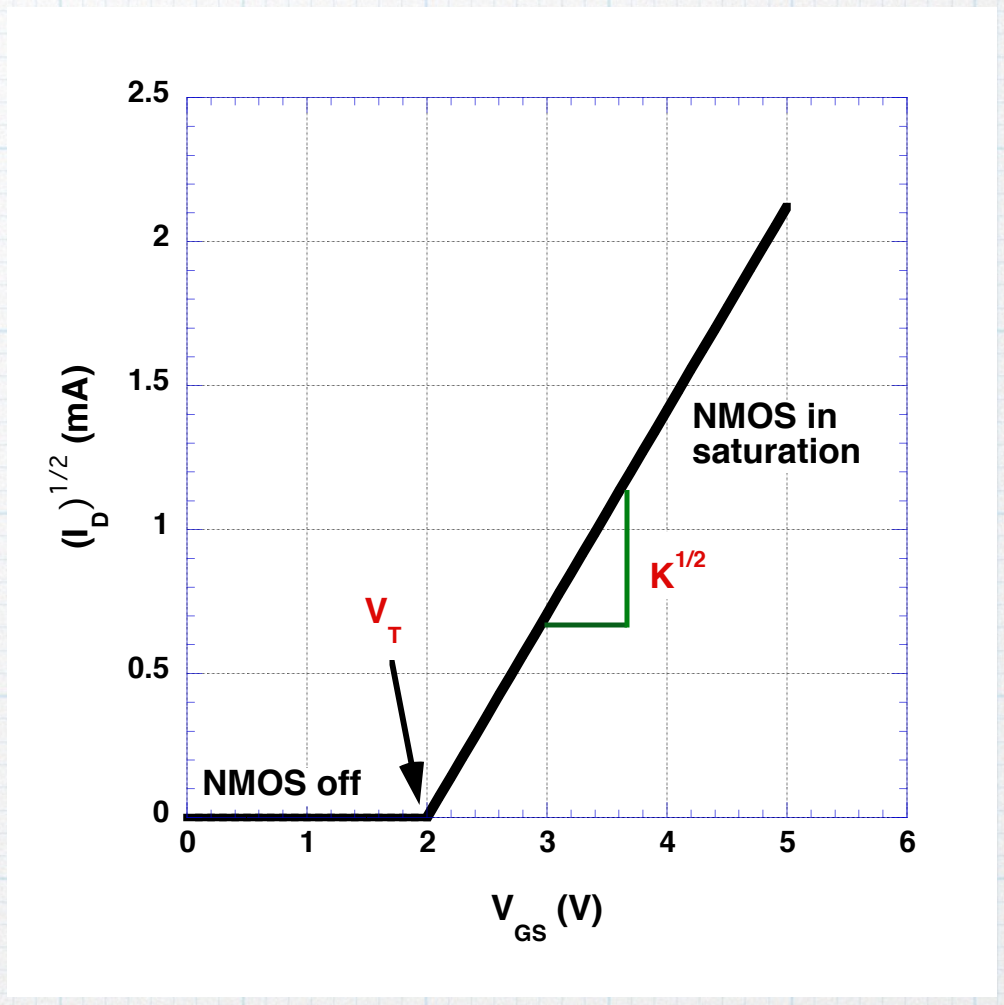
[picture p25: figure]
NMOS off; NMOS in saturation

In a slight modification, we can plot iD1/2= K¹/2(vGS - VT). From this graph, we can immediately pick out the two important NMOS parameters: VT and K.

Another useful plot is iD vs. vGS, with vDS fixed. If vDS is kept large so that the NMOS does not go into the ohmic region, the curve is essentially a plot of the saturation equation.

iD = 0

## Summary of NMOS equations

The equations are exact (within the limits of the simplest MOSFET model). The quadratic dependence of current on voltage means that the circuit analysis will be non-linear and we will have frequent need for the quadratic equation.

vGS < VT | off
vGS ≥ VT | on | vDS < vGS – VT | ohmic or linear
vDS ≥ vGS – VT | saturation

L' =

ܟQ&R[

| : /
| (Y*6 97) Y'6 Y

'6

. =

ܟQ&R[

:
/ VT,

L' = . [Y*6 97]

iG = 0 !! (at least at DC)

## The NMOS substrate (body)

In applying the drain voltage to make the drain current flow, is it necessary to use positive value for vDS? It would seem that vDS < 0 might be OK. However, it's not.

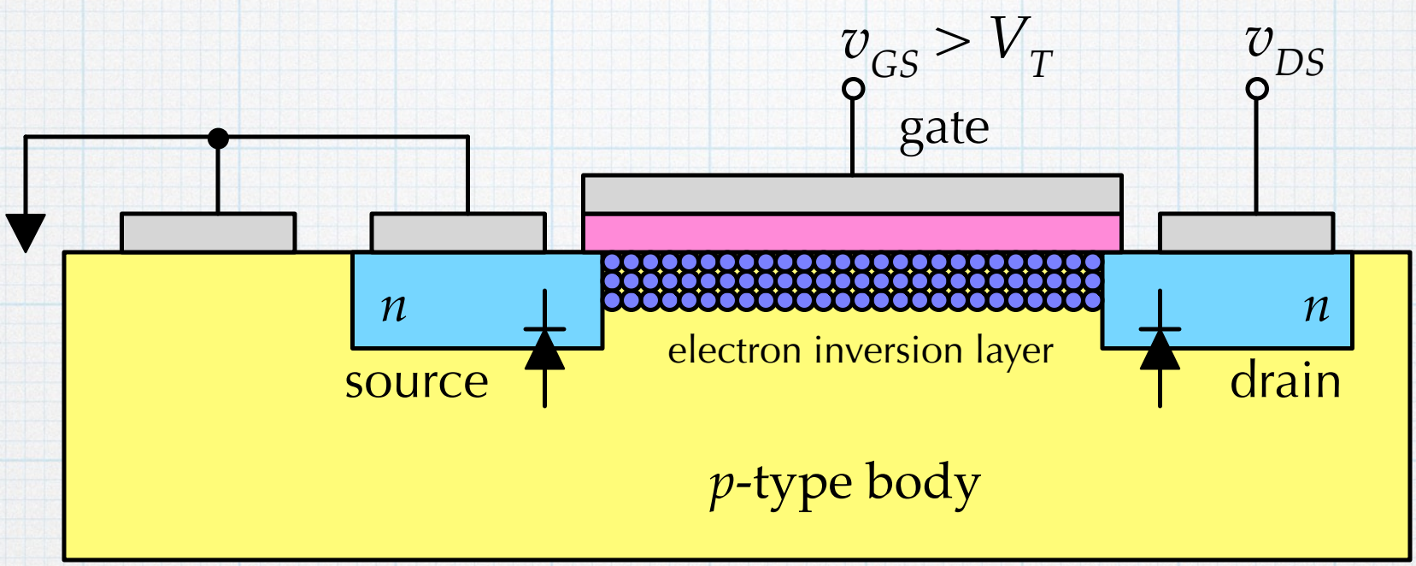
[picture p26: figure]
source; drain; gate; p-type body; vGS > VT; electron inversion layer; vDS

To see why, consider the p-n junctions formed by the drain and source with the substrate.
If the substrate is at ground potential and we apply a negative voltage to the drain, the p-n junction there would be forward-biased – probably with a very large voltage possibly without a limiting resistor – and a huge forward-bias diode current would flow from the substrate into the drain. The junction would likely be burned out. The NMOS substrate rule: The NMOS substrate (body) should be connected to the lowest voltage in the circuit – usually the ground. (Although it could be a negative power supply.) Then the source and drain will both always be at the same or higher voltages, and it will be impossible to forward-bias the diodes.
