chinart123/STM32_Quadcopter/assets/Bare-metal Blocking Architecture & Hardware Constraints.png

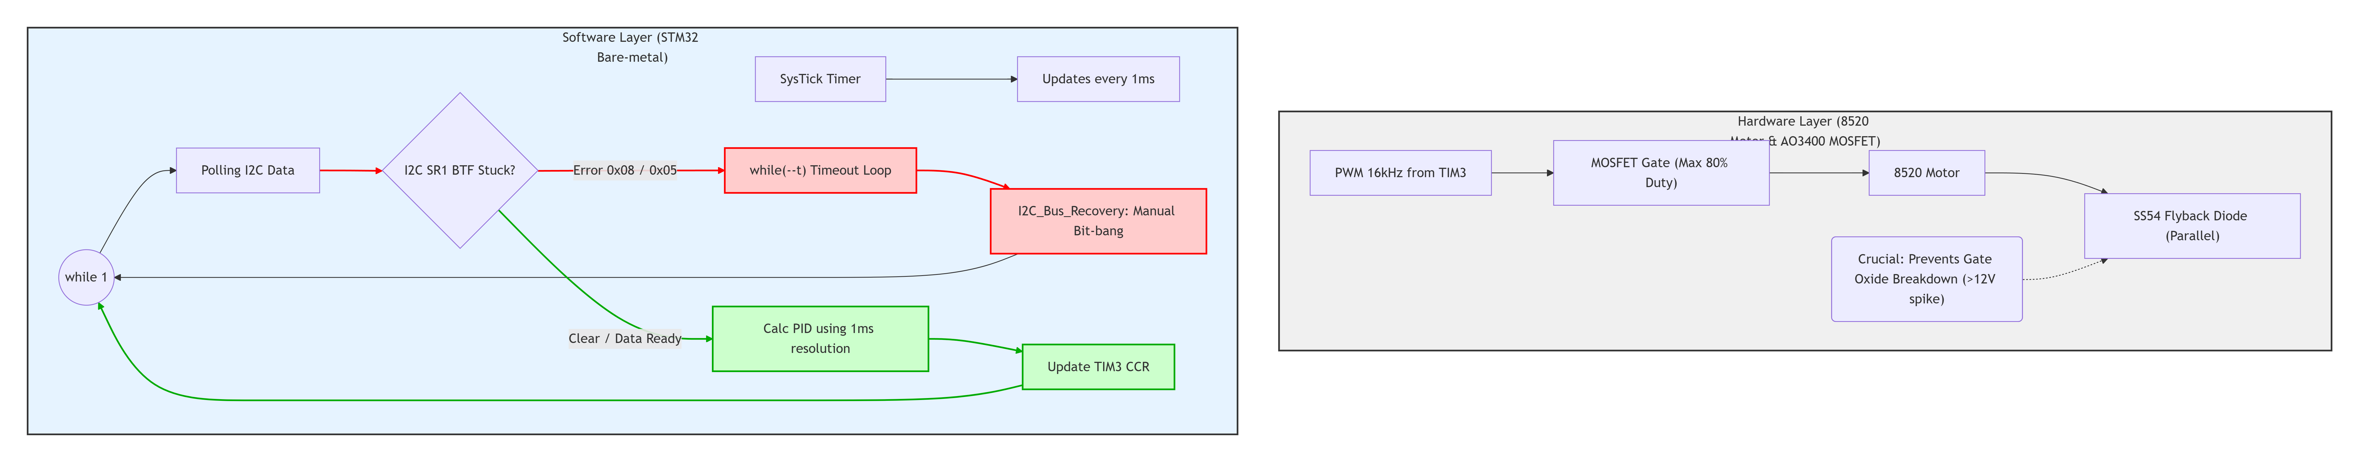
assets/Bare-metal Blocking Architecture & Hardware Constraints.png
