chinart123/STM32_Quadcopter/src/xx_mpu_data_fusion.c

#include "xx_mpu_data_fusion.h"
#include "drn_main_board_choose.h" //#include "i2c_mpu_debug.h" // Gọi tài xế I2C vào làm việc
#include <math.h> // Thư viện toán học cực mạnh để tính Lượng giác
#include "hal_timer_pwm.h" // Dùng cho stage 7
// Khởi tạo biến toàn cục đã khai báo ở file .h
MPU_Motion_t Drone_IMU;

// [ĐÃ SỬA]: Trỏ link trực tiếp sang driver I2C của file xx_mpu_complementary_filter.c
extern void Core_I2C_Write(uint8_t reg, uint8_t data);
extern uint8_t Core_I2C_Read(uint8_t reg, uint8_t *data, uint8_t size);

// Bọc lại thành vỏ bọc cũ để KHÔNG PHẢI SỬA CÁC DÒNG CODE BÊN DƯỚI
uint8_t MPU_WriteReg(uint8_t reg, uint8_t data) {
    Core_I2C_Write(reg, data);
    return 1;
}

uint8_t MPU_Read_Multi(uint8_t reg, uint8_t *data, uint8_t size) {
    return Core_I2C_Read(reg, data, size);
}

// =================================================================
// HÀM CẤU HÌNH MPU-6500 CHUYÊN DỤNG CHO QUADCOPTER
// =================================================================
void MPU_Fusion_Init(void) {
    // 1. Đánh thức cảm biến (Reset thanh ghi Nguồn)
    // Thanh ghi 0x6B (PWR_MGMT_1) -> Ghi 0x00: Dùng xung nhịp nội bộ 8MHz, tắt Sleep.
    MPU_WriteReg(0x6B, 0x00);
    
    // Đợi 1 chút cho cảm biến ổn định dao động ký (Tầm 10ms)
    for(volatile int i=0; i<72000; i++); 

    // 2. Bật Bộ lọc thông thấp kỹ thuật số (DLPF - Digital Low Pass Filter)
    // Thanh ghi 0x1A (CONFIG) -> Ghi 0x03: Lọc nhiễu ở tần số ~41Hz. 
    // Nếu không có dòng này, lúc động cơ quay mạch sẽ rung bần bật, nhiễu không bay nổi!
    MPU_WriteReg(0x1A, 0x03);

    // 3. Cấu hình tầm đo Con quay hồi chuyển (Gyroscope Full Scale Range)
    // Thanh ghi 0x1B (GYRO_CONFIG) -> Ghi 0x08: Chọn dải ±500 độ/giây (dps).
    // Tầm này đủ để Quadcopter nhào lộn mượt mà. Hệ số chia tương ứng là 65.5 LSB/dps.
    MPU_WriteReg(0x1B, 0x08);

    // 4. Cấu hình tầm đo Gia tốc kế (Accelerometer Full Scale Range)
    // Thanh ghi 0x1C (ACCEL_CONFIG) -> Ghi 0x10: Chọn dải ±8g.
    // Chịu được gia tốc gấp 8 lần trọng trường Trái Đất (Phù hợp để bốc đầu). Hệ số chia là 4096 LSB/g.
    MPU_WriteReg(0x1C, 0x10);
    
    // Khởi tạo Struct về 0 cho sạch sẽ
    Drone_IMU.Roll = 0.0f;
    Drone_IMU.Pitch = 0.0f;
    Drone_IMU.Yaw = 0.0f;
}

// =================================================================
// 1. HÀM HÚT 14 BYTES TỪ MPU-6500 (Thanh ghi 0x3B đến 0x48)
// =================================================================
uint8_t MPU_Fusion_Read_Burst(void) {
    uint8_t buffer[14];
    
    // [FIX LỖI]: Nếu Tài xế I2C báo lỗi (0), hất văng ra luôn, tuyệt đối không gán RÁC vào biến RAW
    if (MPU_Read_Multi(0x3B, buffer, 14) == 0) return 0;
    
    // Ép kiểu (Ghép 2 byte 8-bit thành 1 số nguyên có dấu 16-bit)
    Drone_IMU.Accel_X_RAW = (int16_t)((buffer[0] << 8) | buffer[1]);
    Drone_IMU.Accel_Y_RAW = (int16_t)((buffer[2] << 8) | buffer[3]);
    Drone_IMU.Accel_Z_RAW = (int16_t)((buffer[4] << 8) | buffer[5]);
    
    Drone_IMU.Temp_RAW    = (int16_t)((buffer[6] << 8) | buffer[7]);
    
    Drone_IMU.Gyro_X_RAW  = (int16_t)((buffer[8] << 8) | buffer[9]);
    Drone_IMU.Gyro_Y_RAW  = (int16_t)((buffer[10] << 8) | buffer[11]);
    Drone_IMU.Gyro_Z_RAW  = (int16_t)((buffer[12] << 8) | buffer[13]);
    return 1; // Hút sạch sẽ thành công
}

// =================================================================
// THÊM MỚI Ở STAGE 6: HÀM TÌM VÀ TRIỆT TIÊU SAI SỐ (CALIBRATION)
// Lưu ý: Mạch phải ĐƯỢC ĐẶT NẰM IM PHẲNG trên bàn trước khi gọi hàm này
// =================================================================
uint8_t MPU_Fusion_Calibrate(void) {
    int32_t sum_ax = 0, sum_ay = 0, sum_az = 0;
    int32_t sum_gx = 0, sum_gy = 0, sum_gz = 0;
    uint16_t num_samples = 1000; // Lấy 1000 mẫu để tính trung bình
    uint8_t buffer[14]; // SỬA LỖI STAGE 6: Dùng buffer ẩn để không làm nhiễu cửa sổ Watch
    for (uint16_t i = 0; i < num_samples; i++) {
        // [FIX LỖI]: Phá vỡ Án tử 1000 Vòng lặp. Hễ đứt dây 1 nhịp là hủy bỏ ngay lập tức!
        if (MPU_Read_Multi(0x3B, buffer, 14) == 0) return 0;

        
        sum_ax += (int16_t)((buffer[0] << 8) | buffer[1]);
        sum_ay += (int16_t)((buffer[2] << 8) | buffer[3]);
        sum_az += (int16_t)((buffer[4] << 8) | buffer[5]);
        sum_gx += (int16_t)((buffer[8] << 8) | buffer[9]);
        sum_gy += (int16_t)((buffer[10] << 8) | buffer[11]);
        sum_gz += (int16_t)((buffer[12] << 8) | buffer[13]);
        
        // Delay 1 chút (~1ms) để cảm biến kịp nặn ra data mới
        for(volatile int j=0; j<7200; j++); 
    }

    // Tính trung bình và cất vào kho Offset
    Drone_IMU.Accel_X_Offset = sum_ax / num_samples;
    Drone_IMU.Accel_Y_Offset = sum_ay / num_samples;
    // ĐẶC BIỆT: Trục Z chịu lực 1g (4096 LSB), nên sai số = Trung bình - 4096
    Drone_IMU.Accel_Z_Offset = (sum_az / num_samples) - 4096; 
    
    Drone_IMU.Gyro_X_Offset = sum_gx / num_samples;
    Drone_IMU.Gyro_Y_Offset = sum_gy / num_samples;
    Drone_IMU.Gyro_Z_Offset = sum_gz / num_samples;

    // [ĐÃ SỬA]: Thay micros() nguy cơ tràn số bằng DRN_Millis()
    Drone_IMU.last_time = DRN_Millis();
    return 1; // Báo cáo Calibrate thành công
}

// =================================================================
// 2. CỐI XAY TOÁN HỌC (CHUYỂN ĐỔI SỐ LIỆU VÀ TÍNH GÓC)
// =================================================================
void MPU_Fusion_Compute(void) {
    // Bước 1: Scale Dữ liệu (Chia cho hằng số phần cứng)
    // Accel chia 4096 (Cấu hình ±8g). Gyro chia 65.5 (Cấu hình ±500 dps)
    // --- SỬA LOGIC STAGE 6: Lấy Data Thô TRỪ ĐI Offset trước khi chia ---
    // Code cũ: Drone_IMU.Ax = (float)Drone_IMU.Accel_X_RAW / 4096.0f;
    // 1. Trừ Offset và Scale (Giữ nguyên như cũ)
    Drone_IMU.Ax = (float)(Drone_IMU.Accel_X_RAW - Drone_IMU.Accel_X_Offset) / 4096.0f;
    Drone_IMU.Ay = (float)(Drone_IMU.Accel_Y_RAW - Drone_IMU.Accel_Y_Offset) / 4096.0f;
    Drone_IMU.Az = (float)(Drone_IMU.Accel_Z_RAW - Drone_IMU.Accel_Z_Offset) / 4096.0f;

    // Code cũ: Drone_IMU.Gx = (float)Drone_IMU.Gyro_X_RAW / 65.5f;
    Drone_IMU.Gx = (float)(Drone_IMU.Gyro_X_RAW - Drone_IMU.Gyro_X_Offset) / 65.5f;
    Drone_IMU.Gy = (float)(Drone_IMU.Gyro_Y_RAW - Drone_IMU.Gyro_Y_Offset) / 65.5f;
    Drone_IMU.Gz = (float)(Drone_IMU.Gyro_Z_RAW - Drone_IMU.Gyro_Z_Offset) / 65.5f;
    // ---------------------------------------------------------------------

    // 2. Tính Delta Time
    // [ĐÃ SỬA]: Lấy trực tiếp thời gian bằng Mili-giây, và đổi /1000000.0f thành /1000.0f
    uint32_t current_time = DRN_Millis();
    Drone_IMU.dt = (float)(current_time - Drone_IMU.last_time) / 1000.0f; 
    Drone_IMU.last_time = current_time;

    // Bước 2: Dùng Toán học giải tích (Trigonometry) tính góc Roll & Pitch từ Gia tốc
    // Hệ số 57.2957795f dùng để đổi từ đơn vị Radian sang Độ (180/PI)
    float Accel_Roll  = atan2(Drone_IMU.Ay, Drone_IMU.Az) * 57.2957795f;
    
    // Dùng công thức Pythagoras cho trục Pitch để triệt tiêu nhiễu khi xoay ngược
    float Accel_Pitch = atan2(-Drone_IMU.Ax, sqrt(Drone_IMU.Ay * Drone_IMU.Ay + Drone_IMU.Az * Drone_IMU.Az)) * 57.2957795f;
    
    // 3. Tính góc Yaw
    Drone_IMU.Roll  = 0.98f * (Drone_IMU.Roll  + Drone_IMU.Gx * Drone_IMU.dt) + 0.02f * Accel_Roll;
    Drone_IMU.Pitch = 0.98f * (Drone_IMU.Pitch + Drone_IMU.Gy * Drone_IMU.dt) + 0.02f * Accel_Pitch;
    Drone_IMU.Yaw   = Drone_IMU.Yaw + Drone_IMU.Gz * Drone_IMU.dt;
}
/*
2. Giải mã "Ma Thuật Trắng" (Register Map)
Sếp nhìn vào mấy con số 0x1A, 0x1B, 0x1C có thấy lú không? 
Đừng lo, tất cả đều được anh lấy từ "Kinh Thánh" (Datasheet) của hãng InvenSense ra cả đấy:
DLPF (0x1A = 0x03): Cánh quạt Quadcopter thường rung ở tần số rất cao (hàng trăm Hz). 
Bật bộ lọc mức số 3 (0x03) sẽ chém bỏ toàn bộ những cái rung động láo nháo đó, chỉ giữ lại chuyển động nghiêng thực sự của thân máy bay (dưới 41Hz).
Gyro (0x1B = 0x08): Mặc định cảm biến chỉ đo được ±250 độ/giây. 
Quadcopter lật rất nhanh, nếu để mặc định sẽ bị "chạm trần" (kẹt số). 
Nâng lên ±500 dps là con số vàng cho các mạch Flight Controller hiện nay.
Accel (0x1C = 0x10): Mặc định là ±2g (Quá yếu, rơi tự do hoặc thắng gấp là kẹt số). 
Nâng lên ±8g là máy bay rớt cái ạch vẫn đo được thông số.

3. Kịch bản Test ở Main
Để kiểm chứng hàm này không làm treo hệ thống, sếp mở main.c ra, tìm đến cái case 0x01: (Trạng thái Wake-up bằng nút PA1) và nâng cấp nó lên:
C
// ... trong vòng lặp switch(xx) ...
case 0x01: // BẤM PA1 - KHỞI ĐỘNG HỆ THỐNG
    DRN_MPU6050_Init(); // Gọi hàm cấu hình cực xịn vừa viết
    MPU_Read_WhoAmI(&xx_mpu_state, &xx_mpu_id); // Đọc ID xem còn sống không
    
    // Nếu sếp thích hiển thị trực quan, có thể chớp tắt LED xanh 1 cái ở đây để báo Init xong
    break;
*/
