chinart123/STM32_Quadcopter/(commit log)

2026-03-04 Chore: Khởi tạo dự án Quadcopter, chép thư viện HAL_PWM, core header và .gitignore từ STM32_BareMetal_Test
2026-03-04 Fix:Simulator 108MHz, chỉnh lại PSC = 26
    [hal_timer_pwm.c, hal_timer_pwm.h, main.c]
2026-03-04 Chore: Bổ sung file project KeilC, thư mục RTE và main.c
2026-03-06 Stage_1-Fix:MPU6050-I2C-xx_mpu_state0x06 = Kẹt ở Address (Không thấy MPU),Tức là STM32 đã gõ cửa đúng địa chỉ 0xD0, nhưng bên trong con MPU6050 im thít, không thèm kéo chân SDA xuống để báo ACK.
    [button.c, button.h, i2c_mpu_debug.c, i2c_mpu_debug.h, main.c]
2026-03-06 Stage_2-Fix: Sửa lỗi 0x05 liên tục. Lời nguyền 128MHz, Gây ra lỗi 0x08
    [i2c_mpu_debug.c]
2026-03-06 Stage_3-Fix: Với các dòng STM32 đời mới (F4, F0, H7...), viết thế này chip vẫn chạy ngon. Nhưng riêng với STM32F1, hãng ST ghi rõ rành rành: "Khi chỉ đọc duy nhất 1 byte, phần mềm bắt buộc phải xóa c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
    [i2c_mpu_debug.c]
2026-03-06 Stage_4-Fix: MPU-6500 thay vì MPU-6050
    [i2c_mpu_debug.c]
2026-03-06 Docs: Tổng hợp tài liệu, code chuẩn và toàn bộ lưu ý gỡ lỗi I2C MPU6500/6050
2026-03-07 Stage_5-Feat: Xây dựng kiến trúc FSM phân cấp và thuật toán Data Fusion. { - Feat: Viết thư viện xx_mpu_data_fusion (Đọc Burst 14 bytes, tính toán Roll/Pitch). - Feat: Tái cấu trúc main.c áp dụng Hie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
    [i2c_mpu_debug.c, i2c_mpu_debug.h, main.c, xx_mpu_data_fusion.c, xx_mpu_data_fusion.h]
2026-03-07 Stage_6-Feat: Tích hợp thuật toán Calibration triệt tiêu sai số phần cứng MPU6500 - Feat: Viết hàm MPU_Fusion_Calibrate() chạy vòng lặp 1000 mẫu để tìm Offset chuẩn xác cho Accel và Gyro. - Feat: Nân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
    [main.c, xx_mpu_data_fusion.c, xx_mpu_data_fusion.h]
2026-03-08 Stage_7_Release-Refactor: Tái cấu trúc FSM, bọc thép I2C và Tích hợp Complementary Filter - Refactor (i2c_mpu_debug): Đập bỏ Macro, tăng Timeout lên 20ms (500.000 vòng) để triệt tiêu False Positive. 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
    [main.c, xx_mpu_complementary_filter.c, xx_mpu_complementary_filter.h]
2026-03-08 Fix: Cập nhật thư viện TIM4 và in log UART
    [hal_timer_pwm.h, i2c_mpu_debug.c, i2c_mpu_debug.h, main.c, xx_mpu_data_fusion.c, xx_mpu_data_fusion.h]
2026-03-08 index on main: 6b860ce Merge bản Refactor xịn (TIM4, UART, FSM bọc thép), chính thức loại bỏ Sandbox
2026-03-08 Stage_8-Release: Tích hợp PID Mixer, giả lập PWM 4 động cơ và fix lệch trục IMU
    - Tích hợp vòng lặp điều khiển PID (Roll, Pitch, Yaw) để tính toán lực bù trừ.
    - Xây dựng hệ phương trình Motor Mixer cho Quadcopter cấu hình chữ X.
    - Mô phỏng tín hiệu PWM cho 4 động cơ (M1->M4) qua Terminal với Base Throttle = 400 để kiểm chứng thuật toán không cần tải thực.
    - Cập nhật Ma trận chuyển đổi tọa độ (Coordinate Transformation Matrix): Tráo đổi tham số Pitch/Roll và đảo chiều trục Roll để khắc phục hiện tượng Flip of Death.
    [main.c, pid_control.c, pid_control.h]
2026-03-08 Chore: Xóa thư mục RTE khỏi Git tracking theo chuẩn gitignore
2026-03-08 Stage_8-release: Hoàn thiện cốt lõi PID, Motor Mixer và hệ thống Telemetry CSV - Tích hợp thành công thuật toán PID và Bộ trộn động cơ (Motor Mixer) mô phỏng xung PWM cho khung Quadcopter chữ X. - Xử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
    [flight_log_20260309_052959.csv]
2026-03-09 Stage_8-Release: Feat: Hoàn thiện Core Flight Dynamic - 4-motor-mixer (balancing simulation on KeilC) using PID. Building & Refactor(Seperating): Telemetry Module đã được tích hợp trong main.c (print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
    [flight_log_20260309_054806.csv]
2026-03-26 Stage_10-Release: Refactor code, test 1 động cơ pwm(PA6)
2026-03-26 chore: Clean up legacy code and add Stage 10 debugging docs
    [flight_log_20260309_052959.csv, flight_log_20260309_054806.csv]
2026-03-28 Stage_10.5-Release: Power Stage Redesign & Hardware Validation - Trial by Fire: Taming the Inductive Kickback (AO3400 + SS54 Integration)
    {
    // =========================================================================
    // CÁC HẠNG MỤC CÔNG VIỆC ĐÃ HOÀN THÀNH TRONG STAGE 10.5
    // =========================================================================
    1. [Hardware Debugging & Failure Analysis] - Khám nghiệm tử thi phần cứng:
    - Tháo rời và đo đạc độc lập (Out-of-circuit) các linh kiện: MOSFET AO3400, Diode SS54, Trở 10k.
    - Chẩn đoán thành công nguyên nhân cốt lõi: Hiện tượng "The Gate Oxide Breakdown" (Thủng lớp cách điện bu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
    [drn_button.c, drn_button.h, drn_main_board_choose.c, drn_main_board_choose.h, drn_motor_pwm.c, drn_motor_pwm.h, drn_time.c]
2026-04-12 chore: add multiple extend motor's pwm level docs: update "Stage-10.5-Final-Release..." for 4Khz and 16Khz
2026-04-13 docs: adding docs folder for 1 motor pwm testing
2026-04-18 chore: cập nhật .gitignore
2026-04-27 Backup trước khi chạy Script 100 điểm
2026-04-27 refactor: refactor code base STM32F103C8T6
2026-05-07 git commit -m "chore: success build-v1 after refactor
    * delete Old-core-files, delete static keyword in xx_mpu_complementary_filter.c
    * add "#include drn_time.h"
    * remove "i2c_mpu_debug.h" + add "#include drn_main_board_choose.h" in xx_mpu_data_fusion.c
2026-05-07 docs + perf: adding reference manual for naming-convention stage
